AmerWegzyy/IOT_ParkMe/assets/README.md

# Assets

Project media that isn't source code.

## Poster (required for final submission)

The final project poster is stored in `Documentation/images/PARKME_POSTER_2K26-1.png`
and embedded directly in the root `README.md` under the **Poster** section:

```markdown
![ParkMe Project Poster](Documentation/images/PARKME_POSTER_2K26-1.png)
```

## Other assets (optional)

Sound files, project photos, 3D enclosure files (e.g. a printed box for the
boards), etc. can also go here.
`test_pics/` contains google vision api accuracy testing pictures.

> The wiring/connection diagram lives in
> [`../Documentation/images/`](../Documentation/images/) alongside the hardware
> documentation.
