AmerWegzyy/IOT_ParkMe/docs/project_checkpoint.md

# ParkMe Project - Status Checkpoint & Summary

**Date:** June 17, 2026

## 📌 Summary of Recent Work (Yesterday)

* **Architecture & Race Condition Fixes:** 
  * Resolved a race condition where delayed OCR camera success created duplicate logs instead of overwriting the initial `UNIDENTIFIED` ghost log triggered by the ultrasonic sensor.
  * Added "Self-Healing" documentation (`Documentation/hardware_behavior_and_edge_cases.md`) mapping out the exact logging lifecycle and database mutations.
* **Streamlining Local Development:** 
  * Updated `common-commands.md` to reflect our unified server approach. The frontend is now served directly by FastAPI via `StaticFiles`, meaning a single `uvicorn main:app --reload` command serves both the backend API and the frontend web app on port `8000`.
  * Explained environment concepts (`venv`, `environment variables`, `.env`) to help the team understand how Python project dependencies and secrets are managed.
* **Bug Fixes:** 
  * Fixed a local startup crash (`google.auth.exceptions.DefaultCredentialsError`) by integrating `python-dotenv` into `main.py`, `seed_firestore.py`, and `create_auth_users.py`. The backend now automatically loads the `GOOGLE_APPLICATION_CREDENTIALS` from the `.env` file upon startup.
* **Git Cleanliness:** 
  * Updated `.gitignore` to explicitly exclude virtual environments (like `venv2/`) and local agent configurations (`mcp.json`).
  * Provided a step-by-step checklist for the team to clone, configure, and run the project locally.

---

## 📍 Current Project State

* **Backend (FastAPI):** Functioning properly with Firebase/Firestore integration. Handles sensor data, OCR inputs, and serves the static frontend files directly.
* **Frontend:** Functional HTML/CSS/JS frontend that interacts with the backend. 
* **Hardware Integration (ESP32):** Hardware edge-cases and race conditions (e.g., sensor vs. camera timing delays) have been mapped out and handled safely in the backend logic.
* **Database (Firestore):** Seeding scripts are ready and functional. The database schema and logging behaviors are fully established.

---

## 📝 To-Do List / Next Steps

- [ ] **Comprehensive Testing:**
  - [ ] Write and run unit tests for the core backend endpoints.
  - [ ] Perform integration testing between the ESP32 hardware and the backend (simulating real-time parking events).
  - [ ] Test frontend interactions (login, viewing spots, real-time updates).

- [ ] **Deployment:**
  - [ ] **Backend Cloud Deployment:** Deploy the FastAPI backend to a cloud provider (e.g., Google Cloud Run, Render, or Heroku).
  - [ ] **Frontend Firebase Hosting:** Decouple the frontend from the FastAPI server and deploy the static files to Firebase Hosting for faster, dedicated CDN delivery.
  - [ ] Update CORS policies to allow the new Firebase Hosting frontend URL to communicate with the cloud-deployed backend API.
