AmerWegzyy/IOT_ParkMe/assets/test_pics/1234590.jpg

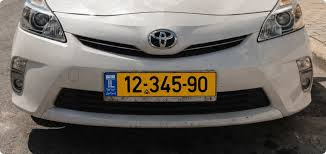
assets/test_pics/1234590.jpg
