AmerWegzyy/IOT_ParkMe/assets/test_pics/1747154.jpg

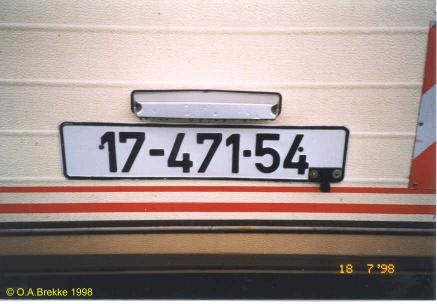
assets/test_pics/1747154.jpg
