AmerWegzyy/IOT_ParkMe/assets/test_pics/1762438.jpg

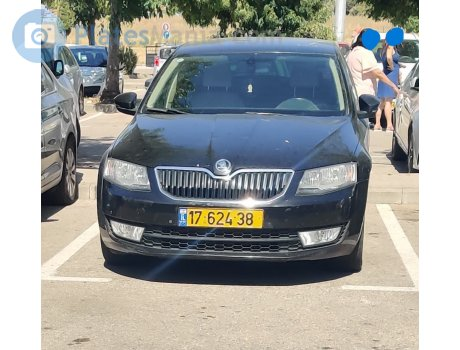
assets/test_pics/1762438.jpg
