AmerWegzyy/IOT_ParkMe/assets/test_pics/1777765.jpg

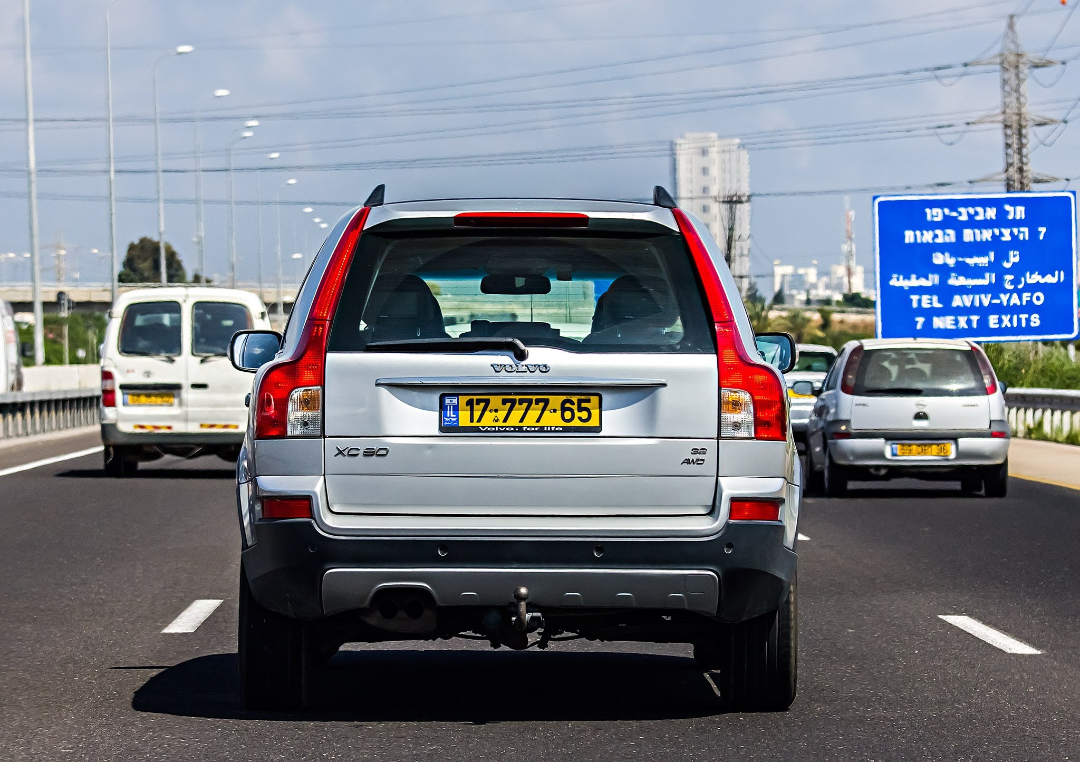
assets/test_pics/1777765.jpg
