AmerWegzyy/IOT_ParkMe/assets/test_pics/3386623.jpg

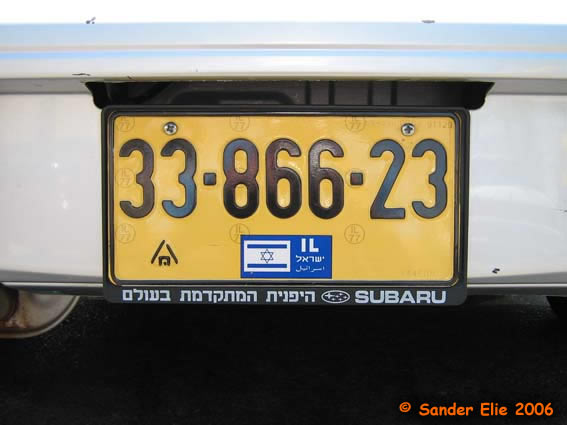
assets/test_pics/3386623.jpg
