AmerWegzyy/IOT_ParkMe/assets/test_pics/4528139.jpg

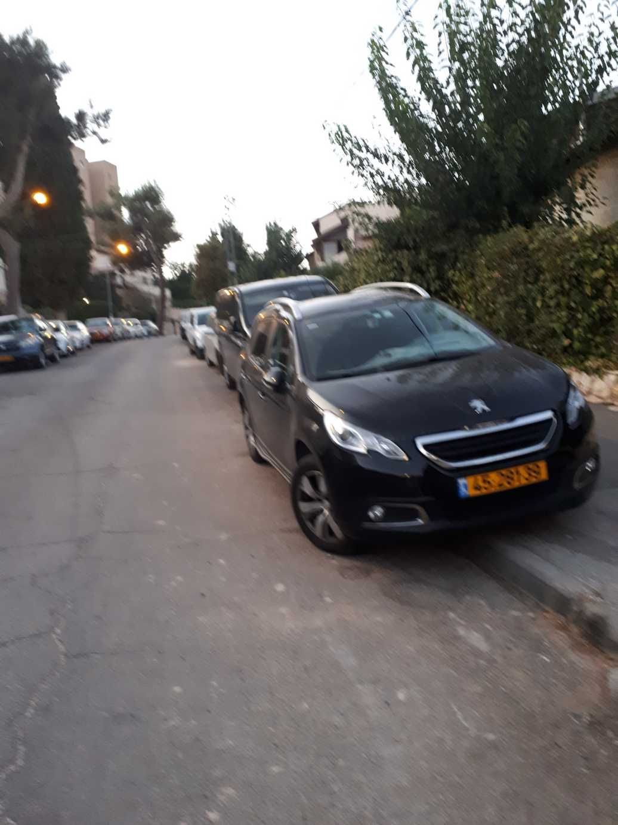
assets/test_pics/4528139.jpg
