AmerWegzyy/IOT_ParkMe/assets/test_pics/5340626.jpg

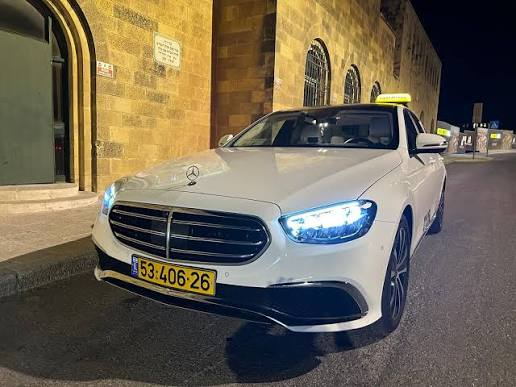
assets/test_pics/5340626.jpg
