AmerWegzyy/IOT_ParkMe/assets/test_pics/5351220.jpg

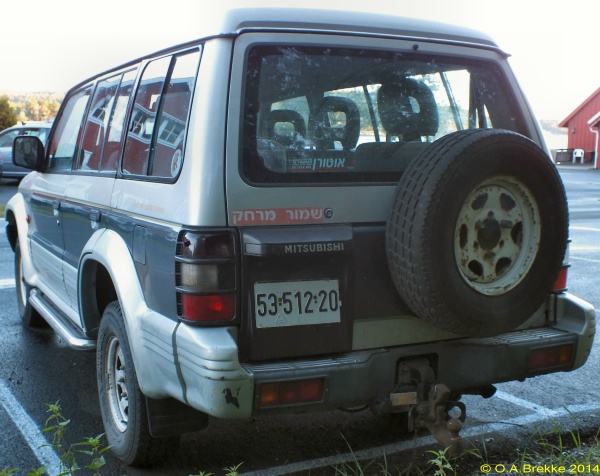
assets/test_pics/5351220.jpg
