AmerWegzyy/IOT_ParkMe/assets/test_pics/5727578.jpg

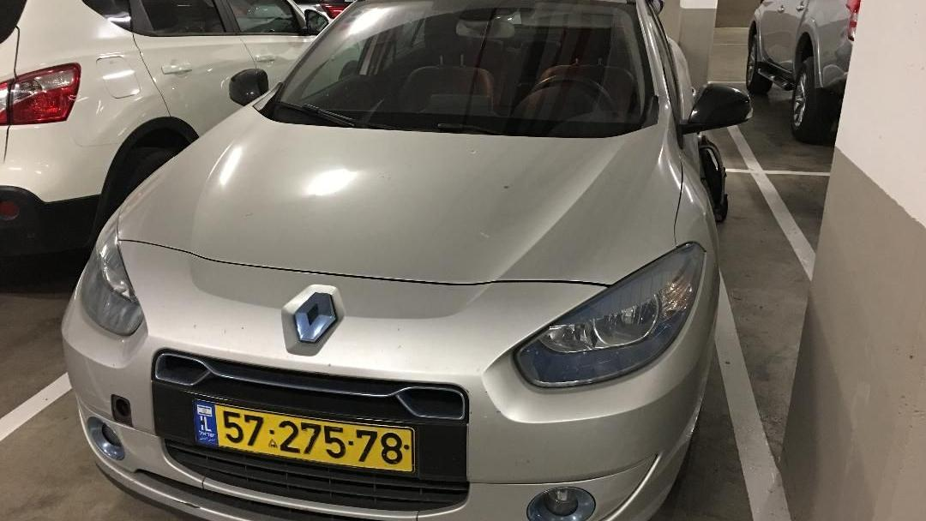
assets/test_pics/5727578.jpg
