AmerWegzyy/IOT_ParkMe/assets/test_pics/5733769.jpg

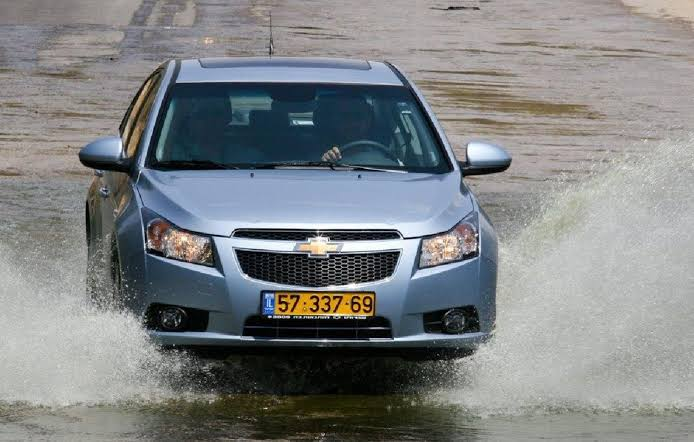
assets/test_pics/5733769.jpg
