AmerWegzyy/IOT_ParkMe/assets/test_pics/5757878.jpg

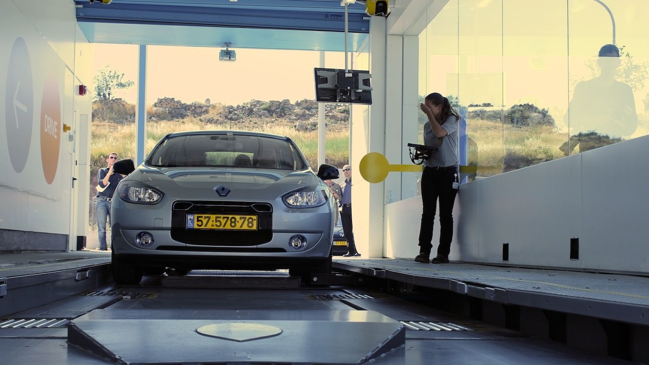
assets/test_pics/5757878.jpg
