AmerWegzyy/IOT_ParkMe/assets/test_pics/6616750.jpg

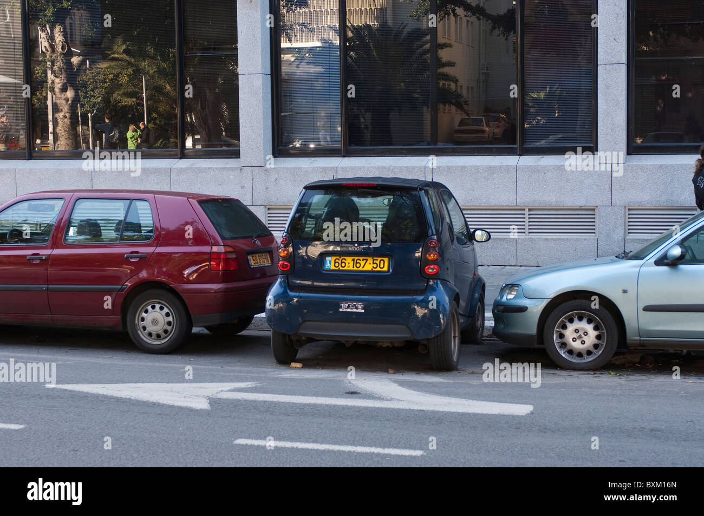
assets/test_pics/6616750.jpg
