AmerWegzyy/IOT_ParkMe/assets/test_pics/7598816.jpg

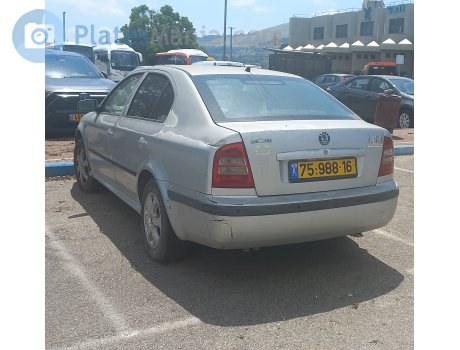
assets/test_pics/7598816.jpg
