AmerWegzyy/IOT_ParkMe/assets/test_pics/7853526.jpg

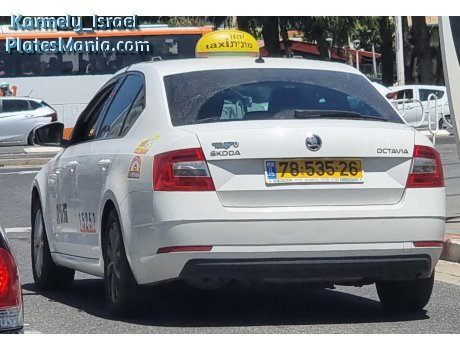
assets/test_pics/7853526.jpg
