AmerWegzyy/IOT_ParkMe/assets/test_pics/7954626.jpg

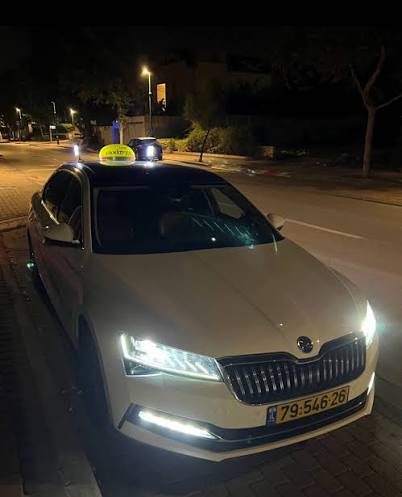
assets/test_pics/7954626.jpg
