AmerWegzyy/IOT_ParkMe/assets/test_pics/9044970.jpg

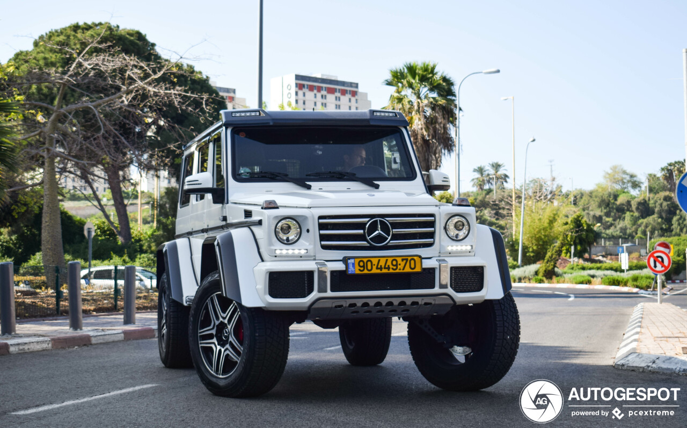
assets/test_pics/9044970.jpg
