AmerWegzyy/IOT_ParkMe/assets/test_pics/9195973.jpg

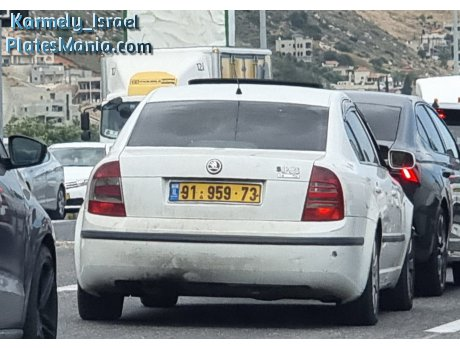
assets/test_pics/9195973.jpg
