AmerWegzyy/IOT_ParkMe/assets/test_pics/9479056.jpg

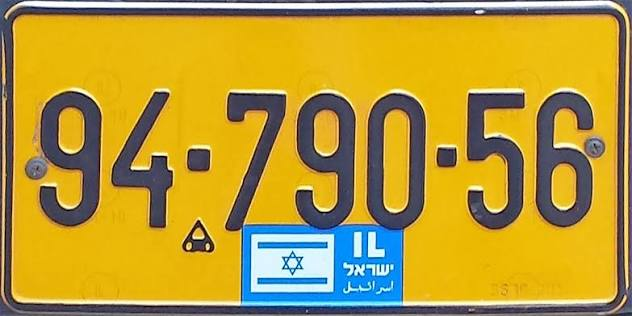
assets/test_pics/9479056.jpg
