AmerWegzyy/IOT_ParkMe/assets/test_pics/9663369.jpg

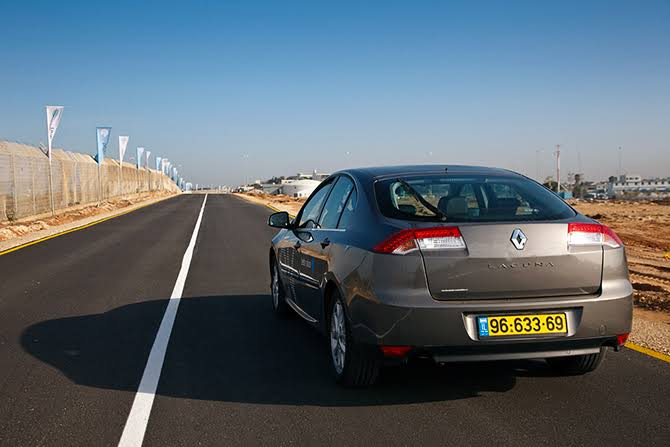
assets/test_pics/9663369.jpg
