AmerWegzyy/IOT_ParkMe/assets/test_pics/9668669.webp

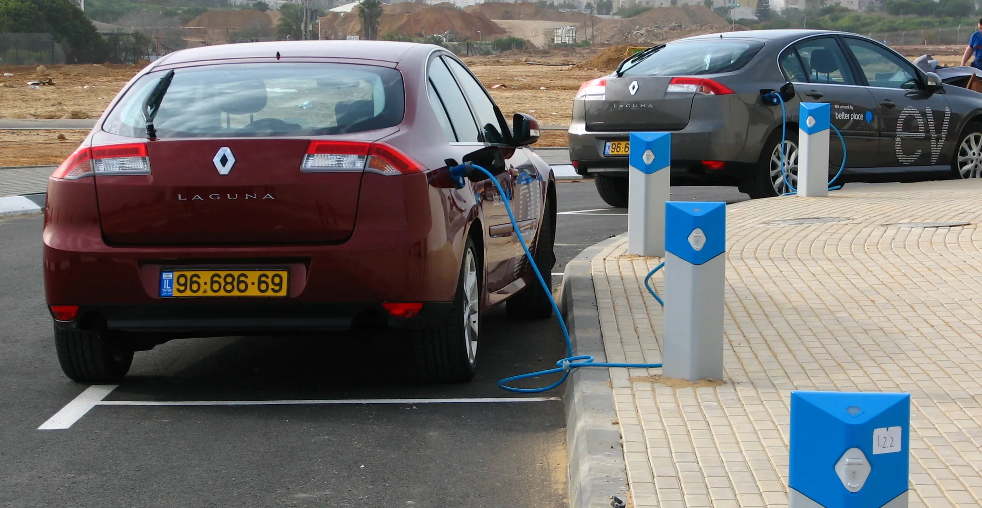
assets/test_pics/9668669.webp
