AmerWegzyy/IOT_ParkMe/assets/test_pics/9703069.jpg

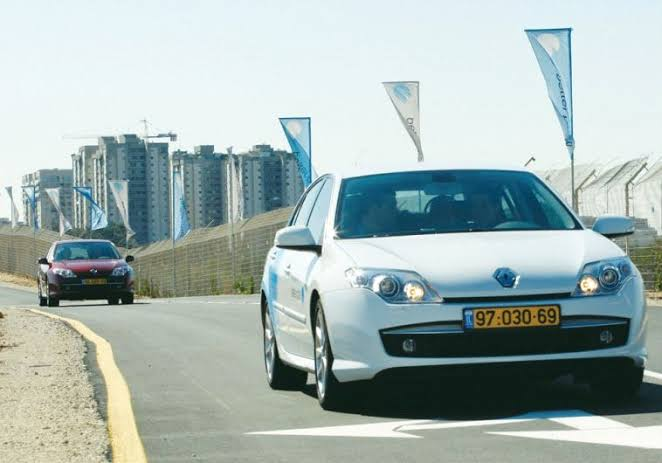
assets/test_pics/9703069.jpg
