AmerWegzyy/IOT_ParkMe/assets/test_pics/9722269.jpg

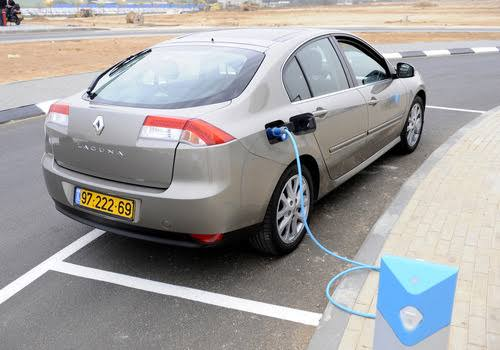
assets/test_pics/9722269.jpg
