AmerWegzyy/IOT_ParkMe/assets/test_pics/26205301.jpg

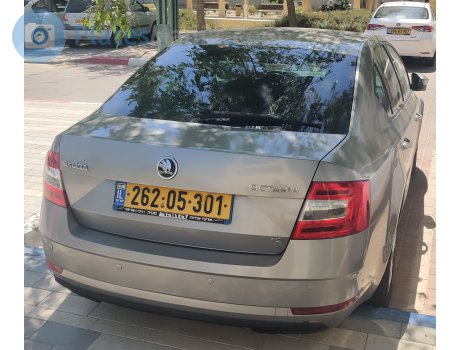
assets/test_pics/26205301.jpg
