AmerWegzyy/IOT_ParkMe/assets/test_pics/28296303.webp

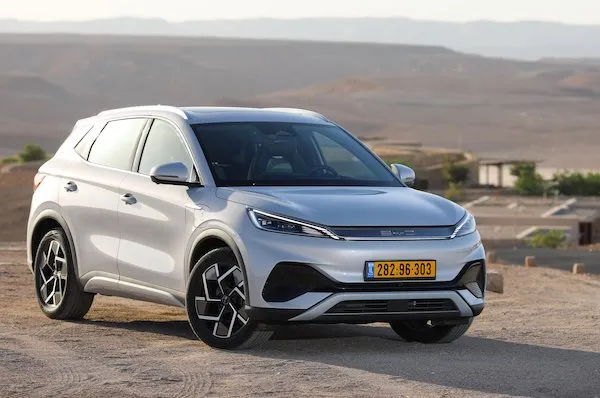
assets/test_pics/28296303.webp
