AmerWegzyy/IOT_ParkMe/assets/test_pics/40940203.jpg

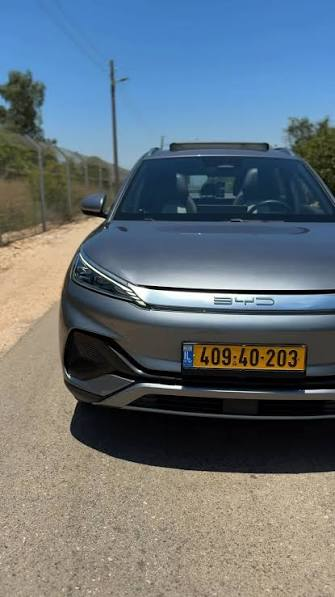
assets/test_pics/40940203.jpg
