AmerWegzyy/IOT_ParkMe/assets/test_pics/47909301.jpg

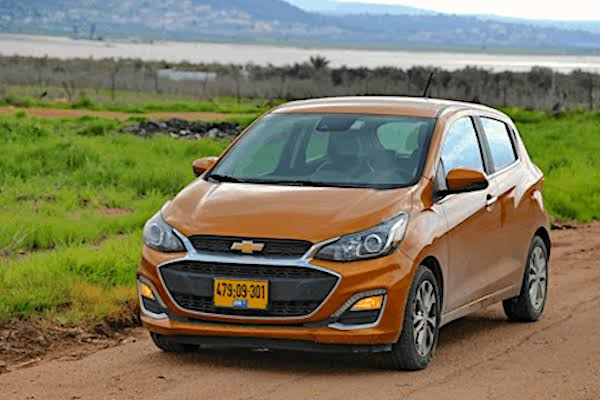
assets/test_pics/47909301.jpg
