AmerWegzyy/IOT_ParkMe/assets/test_pics/49347601.jpg

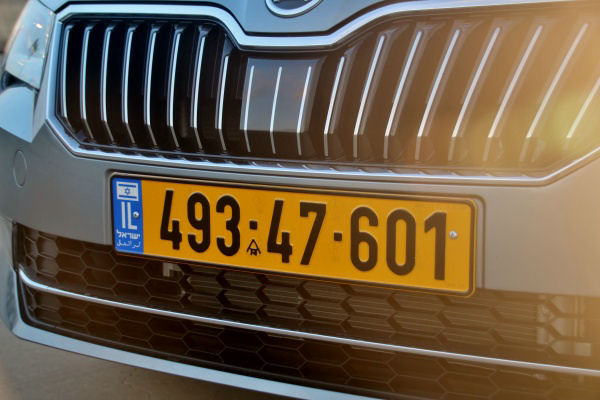
assets/test_pics/49347601.jpg
