AmerWegzyy/IOT_ParkMe/assets/test_pics/57685101.jpg

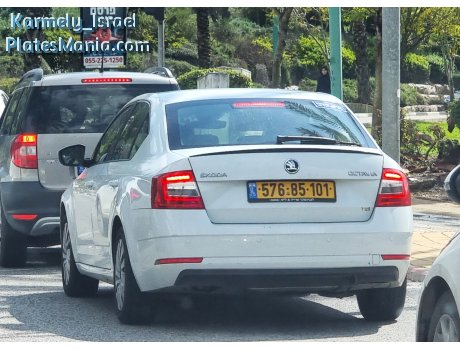
assets/test_pics/57685101.jpg
