AmerWegzyy/IOT_ParkMe/assets/test_pics/60830001.jpg

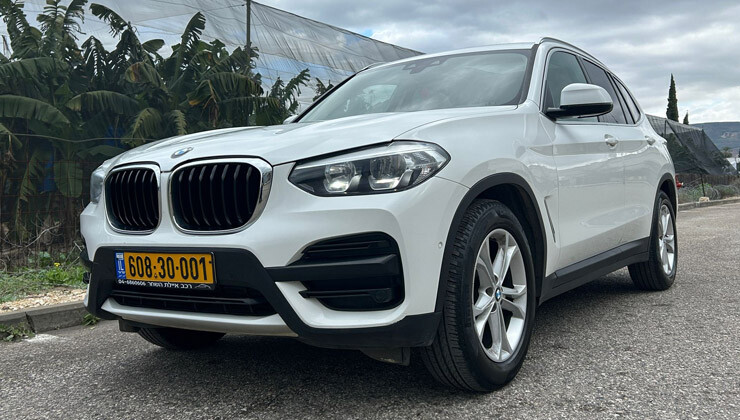
assets/test_pics/60830001.jpg
