AmerWegzyy/IOT_ParkMe/assets/test_pics/71816803.jpg

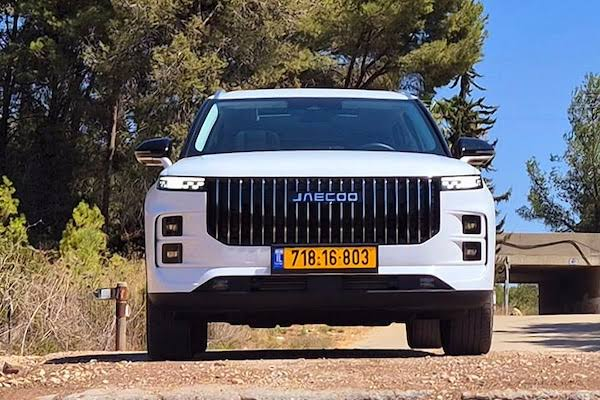
assets/test_pics/71816803.jpg
