AmerWegzyy/IOT_ParkMe/assets/test_pics/77864803.jpg

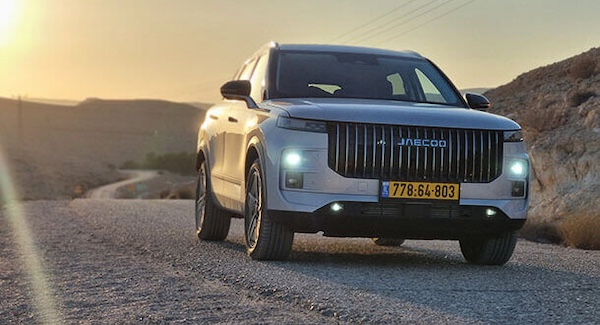
assets/test_pics/77864803.jpg
