AmerWegzyy/IOT_ParkMe/assets/test_pics/83390303.webp

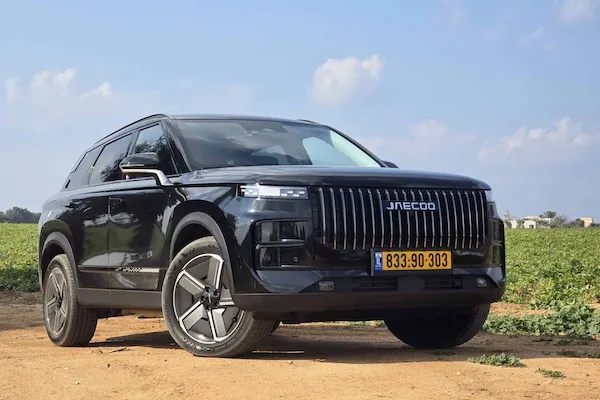
assets/test_pics/83390303.webp
