AmerWegzyy/IOT_ParkMe/ESP32/ParkMeSensorNode/ParkMeSensorNode.ino

#include <HTTPClient.h>
#include <Preferences.h>
#include <esp_now.h>
#include <esp_wifi.h>
#include <WiFi.h>
#include <WiFiClientSecure.h>
#include <Wire.h>

#include "ParkMeCommon.h"
#include "ParkMeConfig.h"

using namespace parkme;

namespace {

Preferences preferences;

struct PendingTelemetry {
  uint8_t status;
  uint8_t batteryPercent;
  uint8_t valid;
  // Set when an unsent FREE (a car leaving) was dropped from this single-slot
  // queue because a later OCCUPIED (the next car) overwrote it during an
  // outage. On reconnect we must deliver a FREE first so the backend closes
  // the previous car's session; otherwise the next car's photo is attributed
  // to the old session and discarded as "already processed".
  uint8_t sessionEndUndelivered;
};

PendingTelemetry pendingTelemetry = {0, 100, 0, 0};

float baselineDistanceCm = PARKME_SENSOR_DEFAULT_BASELINE_CM;
float occupiedThresholdCm = PARKME_SENSOR_OCCUPIED_THRESHOLD_CM;

SpotState lastPublishedState = STATE_UNKNOWN;
unsigned long lastSampleAtMs = 0;
unsigned long lastSuccessfulPublishAtMs = 0;
unsigned long lastWifiAttemptAtMs = 0;
unsigned long calibrationButtonPressedAtMs = 0;
unsigned long lastDisplayPollAtMs = 0;
unsigned long activeMessageUntilAtMs = 0;
unsigned long localCameraMessageUntilAtMs = 0;
unsigned long lastEspNowStateSentAtMs = 0;
// AP channel remembered from the last successful connect; the radio is
// re-pinned to it after failed reconnects so ESP-NOW keeps working during
// WiFi outages (both boards must share a channel for ESP-NOW delivery).
uint8_t lastKnownWifiChannel = 0;

float lastMeasuredDistanceCm = -1.0f;
SpotState lastMeasuredState = STATE_UNKNOWN;
int lastMeasuredBatteryPercent = 100;
SpotState lastEspNowState = STATE_UNKNOWN;
uint32_t lastEspNowSequence = 0;

String currentScreenTitle = "ParkMe";
String currentScreenMessage = "Booting";
String lastRenderedSignature;
String lastEspNowAckDetail;
String localCameraScreenTitle;
String localCameraScreenMessage;

bool graphicsReady = false;
bool espNowReady = false;
uint8_t selectedDisplayAddress = 0;
portMUX_TYPE espNowAckMux = portMUX_INITIALIZER_UNLOCKED;
volatile bool hasPendingEspNowAck = false;
volatile uint8_t pendingEspNowAckStatus = 0;
char pendingEspNowAckDetail[24] = {0};
const uint8_t kEspNowBroadcastPeer[6] = {0xFF, 0xFF, 0xFF, 0xFF, 0xFF, 0xFF};

// FreeRTOS inter-core shared state
SemaphoreHandle_t sharedStateMutex = nullptr;

struct SharedSensorData {
  SpotState state;
  int batteryPercent;
  bool needsTelemetry;
};

struct SharedDisplayCommand {
  char title[24];
  char message[48];
  unsigned long holdMs;
  bool hasNew;
  bool needsAck;
  char requestId[40];
};

struct SharedNetworkStatus {
  bool wifiConnected;
  bool sseConnected;
  unsigned long lastTelemetrySentAtMs;
};

volatile SharedSensorData sharedSensor = {STATE_UNKNOWN, 100, false};
volatile SharedDisplayCommand sharedDisplay = {{0}, {0}, 0, false, false, {0}};
volatile SharedNetworkStatus sharedNetwork = {false, false, 0};

// SSE connection state
unsigned long sseReconnectDelayMs = 3000;
constexpr unsigned long SSE_RECONNECT_MAX_DELAY_MS = 30000;
constexpr unsigned long SSE_RECONNECT_BASE_DELAY_MS = 3000;
unsigned long lastSseAttemptAtMs = 0;
bool sseStreamActive = false;
TaskHandle_t networkTaskHandle = nullptr;
constexpr uint32_t NETWORK_TASK_STACK_SIZE = 8192;

bool addEspNowPeerIfNeeded(const uint8_t peerMac[6]) {
  if (esp_now_is_peer_exist(peerMac)) {
    return true;
  }

  esp_now_peer_info_t peerInfo = {};
  memcpy(peerInfo.peer_addr, peerMac, sizeof(peerInfo.peer_addr));
  peerInfo.channel = 0;
  peerInfo.encrypt = false;
  return esp_now_add_peer(&peerInfo) == ESP_OK;
}

constexpr uint8_t kDisplayWidth = 128;
constexpr uint8_t kDisplayHeight = 64;
constexpr uint8_t kDisplayPages = kDisplayHeight / 8;
constexpr unsigned long kSensorEchoTimeoutUs = 30000;
constexpr float kSensorMeasurementCapCm =
    (kSensorEchoTimeoutUs * 0.0343f) / 2.0f;
uint8_t displayBuffer[kDisplayWidth * kDisplayPages] = {0};

const uint8_t FONT_SPACE[5] = {0x00, 0x00, 0x00, 0x00, 0x00};
// Digit glyphs use the same bit convention as the letters below: bit 0 = top
// row (drawChar tests glyph[col] & (1 << row) with row 0 at the top).
const uint8_t FONT_0[5] = {0x3E, 0x51, 0x49, 0x45, 0x3E};
const uint8_t FONT_1[5] = {0x00, 0x42, 0x7F, 0x40, 0x00};
const uint8_t FONT_2[5] = {0x42, 0x61, 0x51, 0x49, 0x46};
const uint8_t FONT_3[5] = {0x21, 0x41, 0x45, 0x4B, 0x31};
const uint8_t FONT_4[5] = {0x18, 0x14, 0x12, 0x7F, 0x10};
const uint8_t FONT_5[5] = {0x27, 0x45, 0x45, 0x45, 0x39};
const uint8_t FONT_6[5] = {0x3C, 0x4A, 0x49, 0x49, 0x30};
const uint8_t FONT_7[5] = {0x01, 0x71, 0x09, 0x05, 0x03};
const uint8_t FONT_8[5] = {0x36, 0x49, 0x49, 0x49, 0x36};
const uint8_t FONT_9[5] = {0x06, 0x49, 0x49, 0x29, 0x1E};
const uint8_t FONT_A[5] = {0x7E, 0x11, 0x11, 0x11, 0x7E};
const uint8_t FONT_B[5] = {0x7F, 0x49, 0x49, 0x49, 0x36};
const uint8_t FONT_C[5] = {0x3E, 0x41, 0x41, 0x41, 0x22};
const uint8_t FONT_D[5] = {0x7F, 0x41, 0x41, 0x22, 0x1C};
const uint8_t FONT_E[5] = {0x7F, 0x49, 0x49, 0x49, 0x41};
const uint8_t FONT_F[5] = {0x7F, 0x09, 0x09, 0x09, 0x01};
const uint8_t FONT_G[5] = {0x3E, 0x41, 0x49, 0x49, 0x7A};
const uint8_t FONT_H[5] = {0x7F, 0x08, 0x08, 0x08, 0x7F};
const uint8_t FONT_I[5] = {0x00, 0x41, 0x7F, 0x41, 0x00};
const uint8_t FONT_J[5] = {0x20, 0x40, 0x41, 0x3F, 0x01};
const uint8_t FONT_K[5] = {0x7F, 0x08, 0x14, 0x22, 0x41};
const uint8_t FONT_L[5] = {0x7F, 0x40, 0x40, 0x40, 0x40};
const uint8_t FONT_M[5] = {0x7F, 0x02, 0x0C, 0x02, 0x7F};
const uint8_t FONT_N[5] = {0x7F, 0x04, 0x08, 0x10, 0x7F};
const uint8_t FONT_O[5] = {0x3E, 0x41, 0x41, 0x41, 0x3E};
const uint8_t FONT_P[5] = {0x7F, 0x09, 0x09, 0x09, 0x06};
const uint8_t FONT_Q[5] = {0x3E, 0x41, 0x51, 0x21, 0x5E};
const uint8_t FONT_R[5] = {0x7F, 0x09, 0x19, 0x29, 0x46};
const uint8_t FONT_S[5] = {0x46, 0x49, 0x49, 0x49, 0x31};
const uint8_t FONT_T[5] = {0x01, 0x01, 0x7F, 0x01, 0x01};
const uint8_t FONT_U[5] = {0x3F, 0x40, 0x40, 0x40, 0x3F};
const uint8_t FONT_V[5] = {0x1F, 0x20, 0x40, 0x20, 0x1F};
const uint8_t FONT_W[5] = {0x7F, 0x20, 0x18, 0x20, 0x7F};
const uint8_t FONT_X[5] = {0x63, 0x14, 0x08, 0x14, 0x63};
const uint8_t FONT_Y[5] = {0x03, 0x04, 0x78, 0x04, 0x03};
const uint8_t FONT_Z[5] = {0x61, 0x51, 0x49, 0x45, 0x43};

}  // namespace

void handleEspNowSend(const uint8_t *macAddress, esp_now_send_status_t status) {
  Serial.print("ESP-NOW send to ");
  Serial.print(formatMacAddress(macAddress));
  Serial.print(": ");
  Serial.println(status == ESP_NOW_SEND_SUCCESS ? "ok" : "failed");
}

void handleEspNowReceive(const uint8_t *macAddress,
                         const uint8_t *data,
                         int dataLength) {
  if (dataLength != static_cast<int>(sizeof(EspNowCameraAckMessage))) {
    return;
  }

  EspNowCameraAckMessage message = {};
  memcpy(&message, data, sizeof(message));
  if (!isEspNowMessageEnvelopeValid(message, ESPNOW_MESSAGE_CAMERA_ACK)) {
    return;
  }

  lastEspNowAckDetail = String(message.detail);
  Serial.print("ESP-NOW ack from ");
  Serial.print(formatMacAddress(macAddress));
  Serial.print(" seq=");
  Serial.print(message.sequence);
  Serial.print(" status=");
  Serial.print(message.status);
  if (lastEspNowAckDetail.length() > 0) {
    Serial.print(" detail=");
    Serial.print(lastEspNowAckDetail);
  }
  Serial.println();

  portENTER_CRITICAL(&espNowAckMux);
  pendingEspNowAckStatus = message.status;
  memcpy(pendingEspNowAckDetail, message.detail, sizeof(pendingEspNowAckDetail));
  hasPendingEspNowAck = true;
  portEXIT_CRITICAL(&espNowAckMux);
}

bool initEspNow() {
  uint8_t peerMac[6];
  bool hasConfiguredCameraPeer =
      parseMacAddress(PARKME_CAMERA_ESPNOW_PEER_MAC, peerMac);

  if (esp_now_init() != ESP_OK) {
    Serial.println("ESP-NOW init failed on sensor node.");
    return false;
  }

  esp_now_register_send_cb(handleEspNowSend);
  esp_now_register_recv_cb(handleEspNowReceive);

  if (!addEspNowPeerIfNeeded(kEspNowBroadcastPeer)) {
    Serial.println("ESP-NOW could not add the broadcast peer.");
    return false;
  }

  if (hasConfiguredCameraPeer && !addEspNowPeerIfNeeded(peerMac)) {
    Serial.println("ESP-NOW could not add the configured camera peer.");
    return false;
  }

  if (hasConfiguredCameraPeer) {
    Serial.print("ESP-NOW ready. Camera peer: ");
    Serial.println(PARKME_CAMERA_ESPNOW_PEER_MAC);
    Serial.println("ESP-NOW broadcast fallback is also enabled.");
  } else {
    Serial.println("ESP-NOW ready. Using broadcast trigger because the camera peer MAC is empty or invalid.");
  }
  return true;
}

bool takePendingEspNowAck(uint8_t &status, char detailBuffer[24]) {
  bool hasAck = false;
  portENTER_CRITICAL(&espNowAckMux);
  if (hasPendingEspNowAck) {
    status = pendingEspNowAckStatus;
    memcpy(detailBuffer, pendingEspNowAckDetail, 24);
    hasPendingEspNowAck = false;
    hasAck = true;
  }
  portEXIT_CRITICAL(&espNowAckMux);
  return hasAck;
}

bool isTimedMessageActive(unsigned long expiresAtMs) {
  return expiresAtMs > 0 && static_cast<long>(millis() - expiresAtMs) < 0;
}

bool isServerMessageActive() {
  return isTimedMessageActive(activeMessageUntilAtMs);
}

bool isLocalCameraMessageActive() {
  return isTimedMessageActive(localCameraMessageUntilAtMs);
}

bool shouldSendEspNowState(SpotState state, unsigned long nowMs) {
  if (!espNowReady || !isKnownState(state)) {
    return false;
  }

  if (!isKnownState(lastEspNowState) || state != lastEspNowState) {
    return true;
  }

  return nowMs - lastEspNowStateSentAtMs >=
         PARKME_SENSOR_ESPNOW_STATE_SYNC_INTERVAL_MS;
}

void sendEspNowState(SpotState state, int batteryPercent) {
  if (!espNowReady) {
    return;
  }

  unsigned long nowMs = millis();
  if (!shouldSendEspNowState(state, nowMs)) {
    return;
  }

  if (!isKnownState(lastEspNowState) || state != lastEspNowState) {
    lastEspNowSequence++;
    lastEspNowState = state;
  }

  EspNowSensorStateMessage message = {};
  message.magic = PARKME_ESPNOW_PROTOCOL_MAGIC;
  message.version = PARKME_ESPNOW_PROTOCOL_VERSION;
  message.messageType = ESPNOW_MESSAGE_SENSOR_STATE;
  message.sequence = lastEspNowSequence;
  message.state = static_cast<uint8_t>(state);
  message.batteryPercent =
      static_cast<uint8_t>(clampValue(batteryPercent, 0, 100));
  copyStringToFixedBuffer(String(PARKME_GATE_SPOT_ID),
                          message.spotId,
                          sizeof(message.spotId));
  copyStringToFixedBuffer(WiFi.macAddress(),
                          message.senderMac,
                          sizeof(message.senderMac));

  bool sentSuccessfully = false;
  bool directQueued = false;
  bool broadcastQueued = false;

  uint8_t peerMac[6];
  if (parseMacAddress(PARKME_CAMERA_ESPNOW_PEER_MAC, peerMac)) {
    esp_err_t directStatus =
        esp_now_send(peerMac, reinterpret_cast<const uint8_t *>(&message),
                     sizeof(message));
    if (directStatus == ESP_OK) {
      sentSuccessfully = true;
      directQueued = true;
    } else {
      Serial.print("ESP-NOW direct send failed with status ");
      Serial.println(static_cast<int>(directStatus));
    }
  }

  esp_err_t broadcastStatus =
      esp_now_send(kEspNowBroadcastPeer,
                   reinterpret_cast<const uint8_t *>(&message),
                   sizeof(message));
  if (broadcastStatus == ESP_OK) {
    sentSuccessfully = true;
    broadcastQueued = true;
  } else {
    Serial.print("ESP-NOW broadcast send failed with status ");
    Serial.println(static_cast<int>(broadcastStatus));
  }

  if (sentSuccessfully) {
    lastEspNowStateSentAtMs = nowMs;
    Serial.print("ESP-NOW state queued seq=");
    Serial.print(message.sequence);
    Serial.print(" state=");
    Serial.print(state == STATE_OCCUPIED ? "OCCUPIED" : "FREE");
    Serial.print(" direct=");
    Serial.print(directQueued ? "yes" : "no");
    Serial.print(" broadcast=");
    Serial.println(broadcastQueued ? "yes" : "no");
  }
}

const uint8_t *fontFor(char c) {
  switch (c) {
    case '0': return FONT_0;
    case '1': return FONT_1;
    case '2': return FONT_2;
    case '3': return FONT_3;
    case '4': return FONT_4;
    case '5': return FONT_5;
    case '6': return FONT_6;
    case '7': return FONT_7;
    case '8': return FONT_8;
    case '9': return FONT_9;
    case 'A': return FONT_A;
    case 'B': return FONT_B;
    case 'C': return FONT_C;
    case 'D': return FONT_D;
    case 'E': return FONT_E;
    case 'F': return FONT_F;
    case 'G': return FONT_G;
    case 'H': return FONT_H;
    case 'I': return FONT_I;
    case 'J': return FONT_J;
    case 'K': return FONT_K;
    case 'L': return FONT_L;
    case 'M': return FONT_M;
    case 'N': return FONT_N;
    case 'O': return FONT_O;
    case 'P': return FONT_P;
    case 'Q': return FONT_Q;
    case 'R': return FONT_R;
    case 'S': return FONT_S;
    case 'T': return FONT_T;
    case 'U': return FONT_U;
    case 'V': return FONT_V;
    case 'W': return FONT_W;
    case 'X': return FONT_X;
    case 'Y': return FONT_Y;
    case 'Z': return FONT_Z;
    default: return FONT_SPACE;
  }
}

String normalizeDisplayText(String text) {
  text.replace("\n", " ");
  text.toUpperCase();

  for (size_t i = 0; i < text.length(); ++i) {
    char c = text[i];
    bool allowed = (c >= 'A' && c <= 'Z') ||
                   (c >= '0' && c <= '9') ||
                   c == ' ';
    if (!allowed) {
      text.setCharAt(i, ' ');
    }
  }

  return text;
}

void oledCommand(uint8_t command) {
  Wire.beginTransmission(selectedDisplayAddress);
  Wire.write(0x00);
  Wire.write(command);
  Wire.endTransmission();
}

void oledData(const uint8_t *data, uint8_t length) {
  Wire.beginTransmission(selectedDisplayAddress);
  Wire.write(0x40);
  for (uint8_t i = 0; i < length; ++i) {
    Wire.write(data[i]);
  }
  Wire.endTransmission();
}

bool oledAddressResponds(uint8_t address) {
  Wire.beginTransmission(address);
  return Wire.endTransmission() == 0;
}

void oledInit() {
  oledCommand(0xAE);
  oledCommand(0xD5);
  oledCommand(0x80);
  oledCommand(0xA8);
  oledCommand(0x3F);
  oledCommand(0xD3);
  oledCommand(0x00);
  oledCommand(0x40);
  oledCommand(0x8D);
  oledCommand(0x14);
  oledCommand(0xA1);
  oledCommand(0xC8);
  oledCommand(0xDA);
  oledCommand(0x12);
  oledCommand(0x81);
  oledCommand(0xFF);
  oledCommand(0xD9);
  oledCommand(0xF1);
  oledCommand(0xDB);
  oledCommand(0x40);
  oledCommand(0xA4);
  oledCommand(0xA6);
  oledCommand(0xAF);
}

void oledDisplay() {
  for (uint8_t page = 0; page < kDisplayPages; ++page) {
    uint8_t column = PARKME_DISPLAY_COLUMN_OFFSET;
    oledCommand(0xB0 + page);
    oledCommand(0x00 + (column & 0x0F));
    oledCommand(0x10 + ((column >> 4) & 0x0F));

    const uint8_t *pageData = &displayBuffer[page * kDisplayWidth];
    for (uint8_t x = 0; x < kDisplayWidth; x += 16) {
      oledData(&pageData[x], 16);
    }
  }
}

void clearDisplayBuffer() {
  memset(displayBuffer, 0, sizeof(displayBuffer));
}

void setPixel(uint8_t x, uint8_t y, bool enabled) {
  if (x >= kDisplayWidth || y >= kDisplayHeight) {
    return;
  }

  uint16_t index = x + (y / 8) * kDisplayWidth;
  uint8_t mask = 1 << (y % 8);
  if (enabled) {
    displayBuffer[index] |= mask;
  } else {
    displayBuffer[index] &= ~mask;
  }
}

void drawChar(uint8_t x, uint8_t y, char c, uint8_t scale) {
  const uint8_t *glyph = fontFor(c);
  for (uint8_t col = 0; col < 5; ++col) {
    for (uint8_t row = 0; row < 7; ++row) {
      bool pixelOn = glyph[col] & (1 << row);
      for (uint8_t dx = 0; dx < scale; ++dx) {
        for (uint8_t dy = 0; dy < scale; ++dy) {
          setPixel(x + col * scale + dx, y + row * scale + dy, pixelOn);
        }
      }
    }
  }
}

void drawText(uint8_t x, uint8_t y, const String &text, uint8_t scale) {
  uint8_t cursorX = x;
  for (size_t i = 0; i < text.length(); ++i) {
    drawChar(cursorX, y, text[i], scale);
    cursorX += 6 * scale;
  }
}

void splitMessageIntoLines(const String &message, String &line1, String &line2) {
  constexpr size_t kMaxCharsPerLine = 18;
  String normalized = message;
  normalized.replace("\n", " ");
  normalized.trim();

  if (normalized.length() <= kMaxCharsPerLine) {
    line1 = normalized;
    line2 = "";
    return;
  }

  int splitAt = normalized.lastIndexOf(' ', kMaxCharsPerLine);
  if (splitAt <= 0) {
    splitAt = static_cast<int>(kMaxCharsPerLine);
  }

  line1 = normalized.substring(0, splitAt);
  line1.trim();

  line2 = normalized.substring(splitAt);
  line2.trim();
  if (line2.length() > kMaxCharsPerLine) {
    line2 = line2.substring(0, kMaxCharsPerLine);
    line2.trim();
  }
}

void renderToSerial(const String &title, const String &message) {
  String signature = title + "|" + message;
  if (signature == lastRenderedSignature) {
    return;
  }

  lastRenderedSignature = signature;
  Serial.println();
  Serial.println("=== Screen Update ===");
  Serial.println(title);
  if (message.length() > 0) {
    Serial.println(message);
  }
  Serial.println("=====================");
}

void renderToGraphics(const String &title, const String &message) {
  if (!graphicsReady) {
    return;
  }

  String normalizedTitle = normalizeDisplayText(title);
  String normalizedMessage = normalizeDisplayText(message);
  String line1;
  String line2;
  splitMessageIntoLines(normalizedMessage, line1, line2);
  normalizedTitle = fitForLcd(normalizedTitle, 10);
  line1 = fitForLcd(line1, 16);
  line2 = fitForLcd(line2, 16);

  clearDisplayBuffer();
  drawText(4, 4, normalizedTitle, 2);
  drawText(4, 28, line1, 1);
  drawText(4, 44, line2, 1);
  oledDisplay();
}

void showScreen(const String &title, const String &message) {
  currentScreenTitle = title;
  currentScreenMessage = message;
  renderToSerial(title, message);
  renderToGraphics(title, message);
}

bool beginGraphicsDisplay() {
  if (!PARKME_DISPLAY_ENABLE_GRAPHICS) {
    Serial.println("Graphics display disabled in SECRETS.h. Using serial only.");
    return false;
  }

  Wire.begin(PARKME_DISPLAY_SDA_PIN, PARKME_DISPLAY_SCL_PIN);
  Wire.setClock(100000);

  bool foundConfiguredAddress = false;
  uint8_t firstDetectedAddress = 0;
  Serial.print("Scanning I2C on SDA=");
  Serial.print(PARKME_DISPLAY_SDA_PIN);
  Serial.print(" SCL=");
  Serial.println(PARKME_DISPLAY_SCL_PIN);
  for (uint8_t address = 1; address < 127; ++address) {
    Wire.beginTransmission(address);
    uint8_t error = Wire.endTransmission();
    if (error == 0) {
      Serial.print("I2C device found at 0x");
      if (address < 16) {
        Serial.print('0');
      }
      Serial.println(address, HEX);
      if (firstDetectedAddress == 0) {
        firstDetectedAddress = address;
      }
      if (address == PARKME_DISPLAY_I2C_ADDRESS) {
        foundConfiguredAddress = true;
      }
    }
  }

  Serial.print("Configured display address: 0x");
  if (PARKME_DISPLAY_I2C_ADDRESS < 16) {
    Serial.print('0');
  }
  Serial.println(PARKME_DISPLAY_I2C_ADDRESS, HEX);

  if (!foundConfiguredAddress) {
    Serial.println("Configured display address was not found on the I2C bus.");
  }

  uint8_t selectedAddress = PARKME_DISPLAY_I2C_ADDRESS;
  if (!foundConfiguredAddress && firstDetectedAddress != 0) {
    selectedAddress = firstDetectedAddress;
    Serial.print("Using detected display address instead: 0x");
    if (selectedAddress < 16) {
      Serial.print('0');
    }
    Serial.println(selectedAddress, HEX);
  }

  if (selectedAddress == 0) {
    Serial.println("No I2C display address available.");
    return false;
  }

  if (!oledAddressResponds(selectedAddress)) {
    Serial.println("Selected OLED address did not respond.");
    return false;
  }

  selectedDisplayAddress = selectedAddress;
  Serial.println("Display driver: LOW-LEVEL SSD1306/SH1106 STYLE");
  oledInit();
  clearDisplayBuffer();
  drawText(10, 12, "WELCOME", 2);
  drawText(34, 44, "PARKME", 1);
  oledDisplay();
  delay(500);
  return true;
}

void showLocalSensorScreen() {
  String title = String("Spot ") + PARKME_GATE_SPOT_ID;
  String message;

  if (!isKnownState(lastMeasuredState)) {
    message = "Waiting sensor";
  } else if (lastMeasuredState == STATE_OCCUPIED) {
    message = "Occupied ";
    if (lastMeasuredDistanceCm > 0.0f) {
      message += String(lastMeasuredDistanceCm, 0);
      message += "cm";
    }
  } else {
    message = "Free ";
    if (lastMeasuredDistanceCm > 0.0f) {
      message += String(lastMeasuredDistanceCm, 0);
      message += "cm";
    }
  }

  message += " B";
  message += String(lastMeasuredBatteryPercent);
  message += "%";

  showScreen(title, message);
}

void clearLocalCameraMessage() {
  localCameraMessageUntilAtMs = 0;
  localCameraScreenTitle = "";
  localCameraScreenMessage = "";
}

void showPreferredLocalScreen() {
  if (isServerMessageActive()) {
    return;
  }

  if (isLocalCameraMessageActive()) {
    showScreen(localCameraScreenTitle, localCameraScreenMessage);
    return;
  }

  showLocalSensorScreen();
}

void showLocalCameraMessage(const String &title,
                            const String &message,
                            unsigned long holdMs) {
  localCameraScreenTitle = title;
  localCameraScreenMessage = message;
  localCameraMessageUntilAtMs = millis() + holdMs;
  showPreferredLocalScreen();
}

void handleCameraAckDisplay(uint8_t status, const char *detail) {
  if (detail && *detail) {
    lastEspNowAckDetail = String(detail);
  }

  switch (status) {
    case ESPNOW_CAMERA_ACK_RECEIVED:
      showLocalCameraMessage("Camera ready",
                             "Queued",
                             PARKME_DISPLAY_CAMERA_QUEUED_HOLD_MS);
      break;
    case ESPNOW_CAMERA_ACK_CAPTURE_STARTED:
      showLocalCameraMessage("Taking photo",
                             "Please hold",
                             PARKME_DISPLAY_CAMERA_STARTED_HOLD_MS);
      break;
    case ESPNOW_CAMERA_ACK_CAPTURE_COMPLETED:
      showLocalCameraMessage("Photo sent",
                             "Checking plate",
                             PARKME_DISPLAY_CAMERA_COMPLETED_HOLD_MS);
      break;
    case ESPNOW_CAMERA_ACK_CAPTURE_FAILED:
      showLocalCameraMessage("Photo failed",
                             "Check dashboard",
                             PARKME_DISPLAY_CAMERA_FAILED_HOLD_MS);
      break;
    case ESPNOW_CAMERA_ACK_SPOT_FREED:
      clearLocalCameraMessage();
      showPreferredLocalScreen();
      break;
    default:
      break;
  }
}

unsigned long extractJsonUnsignedLongField(const String &payload,
                                           const char *fieldName,
                                           unsigned long fallbackValue) {
  String keyPattern = "\"";
  keyPattern += fieldName;
  keyPattern += "\"";

  int keyStart = payload.indexOf(keyPattern);
  if (keyStart < 0) {
    return fallbackValue;
  }

  int colonIndex = payload.indexOf(':', keyStart + keyPattern.length());
  if (colonIndex < 0) {
    return fallbackValue;
  }

  int valueStart = colonIndex + 1;
  while (valueStart < payload.length() &&
         isspace(static_cast<unsigned char>(payload[valueStart]))) {
    ++valueStart;
  }

  int valueEnd = valueStart;
  while (valueEnd < payload.length() &&
         isdigit(static_cast<unsigned char>(payload[valueEnd]))) {
    ++valueEnd;
  }

  if (valueEnd <= valueStart) {
    return fallbackValue;
  }

  return static_cast<unsigned long>(
      payload.substring(valueStart, valueEnd).toInt());
}

bool sendDisplayJsonRequest(const char *path,
                            const String &payload,
                            String &responseBody,
                            int &httpStatusCode) {
  WiFiClient plainClient;
  WiFiClientSecure secureClient;
  Client *client =
      String(PARKME_SERVER_SCHEME) == "https" ? &secureClient : &plainClient;
  secureClient.setInsecure();
  client->setTimeout(PARKME_DISPLAY_HTTP_TIMEOUT_MS);

  if (!client->connect(PARKME_SERVER_HOST, PARKME_SERVER_PORT)) {
    Serial.println("Display request cannot reach backend.");
    return false;
  }

  client->print(String("POST ") + path + " HTTP/1.1\r\n");
  client->print(String("Host: ") + PARKME_SERVER_HOST + "\r\n");
  client->print("Connection: close\r\n");
  client->print("Content-Type: application/json\r\n");
  client->print("Content-Length: " + String(payload.length()) + "\r\n\r\n");
  client->print(payload);

  unsigned long waitStartedAtMs = millis();
  while (!client->available() && client->connected() &&
         millis() - waitStartedAtMs < PARKME_DISPLAY_HTTP_TIMEOUT_MS) {
    delay(10);
  }

  if (!client->available()) {
    client->stop();
    Serial.println("Display backend response timeout.");
    return false;
  }

  String statusLine = client->readStringUntil('\n');
  httpStatusCode = parseHttpStatusCode(statusLine);

  while (client->connected()) {
    String headerLine = client->readStringUntil('\n');
    if (headerLine == "\r" || headerLine.length() == 0) {
      break;
    }
  }

  responseBody = client->readString();
  client->stop();
  return true;
}

bool pollDisplayCommand(String &requestId,
                        String &title,
                        String &message,
                        unsigned long &holdMs) {
  String payload = "{\"display_id\":\"";
  payload += PARKME_DISPLAY_ID;
  payload += "\"}";

  String responseBody;
  int httpStatusCode = -1;
  if (!sendDisplayJsonRequest(PARKME_API_DISPLAY_POLL_PATH,
                              payload,
                              responseBody,
                              httpStatusCode)) {
    return false;
  }

  if (httpStatusCode < 200 || httpStatusCode >= 300) {
    Serial.print("Display poll rejected with HTTP ");
    Serial.println(httpStatusCode);
    return false;
  }

  String action = extractJsonStringField(responseBody, "action");
  action.toUpperCase();
  if (action != "SHOW_MESSAGE") {
    return false;
  }

  requestId = extractJsonStringField(responseBody, "request_id");
  title = extractJsonStringField(responseBody, "title");
  message = extractJsonStringField(responseBody, "message");
  holdMs = extractJsonUnsignedLongField(responseBody, "hold_ms", 4000);
  return requestId.length() > 0;
}

void sendDisplayResult(const String &requestId,
                       const String &statusText,
                       const String &detail) {
  String payload = "{\"display_id\":\"";
  payload += PARKME_DISPLAY_ID;
  payload += "\",\"request_id\":\"";
  payload += requestId;
  payload += "\",\"status\":\"";
  payload += statusText;
  payload += "\",\"detail\":\"";
  payload += detail;
  payload += "\"}";

  String responseBody;
  int httpStatusCode = -1;
  if (!sendDisplayJsonRequest(PARKME_API_DISPLAY_RESULT_PATH,
                              payload,
                              responseBody,
                              httpStatusCode)) {
    Serial.println("Failed to acknowledge display command.");
    return;
  }

  Serial.print("Display ACK HTTP ");
  Serial.print(httpStatusCode);
  Serial.print(" | ");
  Serial.println(responseBody);
}

void handleDisplayPolling() {
  bool shouldRefreshScreen = false;

  if (activeMessageUntilAtMs > 0 &&
      static_cast<long>(millis() - activeMessageUntilAtMs) >= 0) {
    activeMessageUntilAtMs = 0;
    shouldRefreshScreen = true;
  }

  if (localCameraMessageUntilAtMs > 0 &&
      static_cast<long>(millis() - localCameraMessageUntilAtMs) >= 0) {
    clearLocalCameraMessage();
    shouldRefreshScreen = true;
  }

  if (shouldRefreshScreen) {
    showPreferredLocalScreen();
  }

  if (WiFi.status() != WL_CONNECTED) {
    return;
  }

  if (millis() - lastDisplayPollAtMs < PARKME_DISPLAY_COMMAND_POLL_INTERVAL_MS) {
    return;
  }

  lastDisplayPollAtMs = millis();

  String requestId;
  String title;
  String message;
  unsigned long holdMs = 4000;
  if (pollDisplayCommand(requestId, title, message, holdMs)) {
    Serial.print("Display command received: ");
    Serial.println(requestId);
    clearLocalCameraMessage();
    activeMessageUntilAtMs = millis() + holdMs;
    showScreen(title.length() > 0 ? title : "ParkMe", message);
    sendDisplayResult(requestId, "DISPLAYED", "rendered");
  }
}

float readDistanceCm() {
  digitalWrite(PARKME_SENSOR_TRIG_PIN, LOW);
  delayMicroseconds(2);

  digitalWrite(PARKME_SENSOR_TRIG_PIN, HIGH);
  delayMicroseconds(10);
  digitalWrite(PARKME_SENSOR_TRIG_PIN, LOW);

  long durationUs = pulseIn(PARKME_SENSOR_ECHO_PIN, HIGH, kSensorEchoTimeoutUs);
  if (durationUs == 0) {
    return -1.0f;
  }

  return (durationUs * 0.0343f) / 2.0f;
}

bool calibrationButtonPressed() {
  if (PARKME_SENSOR_CALIBRATE_PIN < 0) {
    return false;
  }
  return digitalRead(PARKME_SENSOR_CALIBRATE_PIN) == LOW;
}

void persistPendingTelemetry() {
  preferences.putBytes("pending", &pendingTelemetry, sizeof(pendingTelemetry));
}

void clearPendingTelemetry() {
  pendingTelemetry.valid = 0;
  // Note: sessionEndUndelivered is intentionally NOT cleared here — a delivered
  // OCCUPIED does not undo the fact that a car-left event still owes the backend
  // a FREE. It is cleared only once that FREE is actually sent.
  persistPendingTelemetry();
}

void queuePendingTelemetry(SpotState state, int batteryPercent) {
  // If we're about to overwrite an unsent FREE with an OCCUPIED, the car-left
  // event would be lost. Remember it so the reconnect flush sends a FREE first.
  if (pendingTelemetry.valid &&
      static_cast<SpotState>(pendingTelemetry.status) == STATE_FREE &&
      state == STATE_OCCUPIED) {
    pendingTelemetry.sessionEndUndelivered = 1;
  }
  pendingTelemetry.status = static_cast<uint8_t>(state);
  pendingTelemetry.batteryPercent =
      static_cast<uint8_t>(clampValue(batteryPercent, 0, 100));
  pendingTelemetry.valid = 1;
  persistPendingTelemetry();
}

void loadPendingTelemetry() {
  size_t loaded =
      preferences.getBytes("pending", &pendingTelemetry, sizeof(pendingTelemetry));
  if (loaded != sizeof(pendingTelemetry)) {
    pendingTelemetry = {0, 100, 0, 0};
  }
}

// If a car-left (FREE) was dropped from the queue by a later OCCUPIED, deliver
// that FREE first so the backend closes the previous car's session before the
// new car's OCCUPIED/photo arrive. Returns false if the FREE still can't be
// sent (caller should hold off sending the OCCUPIED so ordering is preserved).
bool deliverPendingSessionEnd(int batteryPercent) {
  if (!pendingTelemetry.sessionEndUndelivered) {
    return true;
  }
  if (postTelemetry(STATE_FREE, batteryPercent)) {
    pendingTelemetry.sessionEndUndelivered = 0;
    persistPendingTelemetry();
    Serial.println("Delivered dropped car-left (FREE) before next arrival.");
    return true;
  }
  return false;
}

void loadCalibration() {
  baselineDistanceCm = PARKME_SENSOR_DEFAULT_BASELINE_CM;
  // Technician-set trigger distance; compiled default until calibrated once.
  occupiedThresholdCm =
      preferences.getFloat("thr_cm", PARKME_SENSOR_OCCUPIED_THRESHOLD_CM);
}

void saveCalibration(float measuredTargetCm) {
  // The measured target distance itself becomes the trigger (plus a small
  // margin), so the technician freely chooses any trigger distance by simply
  // placing the target where a car should be detected.
  occupiedThresholdCm =
      clampValue(measuredTargetCm + PARKME_SENSOR_CALIBRATION_MARGIN_CM,
                 PARKME_SENSOR_MIN_THRESHOLD_CM,
                 PARKME_SENSOR_CALIBRATION_MAX_TARGET_CM);
  preferences.putFloat("thr_cm", occupiedThresholdCm);
}

float sampleAverageDistance(uint8_t sampleCount) {
  float total = 0.0f;
  uint8_t validSamples = 0;

  for (uint8_t i = 0; i < sampleCount; ++i) {
    float distanceCm = readDistanceCm();
    if (distanceCm > 0.0f && distanceCm <= kSensorMeasurementCapCm) {
      total += distanceCm;
      ++validSamples;
    }
    delay(120);
  }

  return validSamples == 0 ? -1.0f : (total / validSamples);
}

void runCalibrationMode() {
  Serial.println(
      "Calibration mode started. Place an object at the desired trigger "
      "distance (up to 50 cm).");
  showScreen("Calibrating", "Measuring target");
  float measuredCm = sampleAverageDistance(15);

  if (measuredCm <= 0.0f) {
    Serial.println(
        "Calibration FAILED: no echo received. Keeping previous threshold.");
    showScreen("Calibrate FAIL", "No echo");
    delay(3000);
    showLocalSensorScreen();
    return;
  }

  if (measuredCm > PARKME_SENSOR_CALIBRATION_MAX_TARGET_CM) {
    Serial.print("Calibration FAILED: target measured at ");
    Serial.print(measuredCm);
    Serial.print(" cm, beyond the ");
    Serial.print(PARKME_SENSOR_CALIBRATION_MAX_TARGET_CM);
    Serial.println(" cm maximum. Keeping previous threshold.");
    showScreen("Calibrate FAIL", "Target too far");
    delay(3000);
    showLocalSensorScreen();
    return;
  }

  saveCalibration(measuredCm);
  Serial.print("Calibration PASS. Target measured at ");
  Serial.print(measuredCm);
  Serial.print(" cm | New trigger distance: ");
  Serial.print(occupiedThresholdCm);
  Serial.println(" cm (saved to flash)");
  showScreen("Calibrate PASS",
             "Trigger " + String(occupiedThresholdCm, 0) + "cm");
  delay(3000);
  showLocalSensorScreen();
}

float readBatteryVoltage() {
  if (PARKME_SENSOR_BATTERY_PIN < 0) {
    return PARKME_SENSOR_BATTERY_FULL_V;
  }

  uint32_t millivolts = analogReadMilliVolts(PARKME_SENSOR_BATTERY_PIN);
  float measuredVoltage = millivolts / 1000.0f;
  return measuredVoltage * PARKME_SENSOR_VOLTAGE_DIVIDER_RATIO;
}

int readBatteryPercent() {
  return batteryPercentFromVoltage(readBatteryVoltage(),
                                   PARKME_SENSOR_BATTERY_EMPTY_V,
                                   PARKME_SENSOR_BATTERY_FULL_V);
}

bool connectWiFi() {
  lastWifiAttemptAtMs = millis();

  showScreen("Connecting WiFi", "Please wait");
  Serial.print("Connecting to WiFi");
  WiFi.begin(PARKME_WIFI_SSID, PARKME_WIFI_PASSWORD);

  unsigned long startedAtMs = millis();
  while (WiFi.status() != WL_CONNECTED && millis() - startedAtMs < 12000) {
    delay(400);
    Serial.print(".");
  }

  Serial.println();
  if (WiFi.status() == WL_CONNECTED) {
    lastKnownWifiChannel = WiFi.channel();
    Serial.print("Connected. IP: ");
    Serial.print(WiFi.localIP());
    Serial.print(" channel: ");
    Serial.println(lastKnownWifiChannel);
    Serial.print("MAC: ");
    Serial.println(WiFi.macAddress());
    showLocalSensorScreen();
    return true;
  }

  // Park the radio back on the AP's channel so ESP-NOW broadcasts to the
  // camera stay on the channel it listens on while WiFi is down. Without
  // this, channel scans leave the two boards on different channels during
  // long outages and the camera never receives the occupancy triggers.
  WiFi.disconnect();
  uint8_t pinChannel = lastKnownWifiChannel > 0 ? lastKnownWifiChannel : 1;
  esp_wifi_set_channel(pinChannel, WIFI_SECOND_CHAN_NONE);
  Serial.print("WiFi connection failed. Radio pinned to channel ");
  Serial.println(pinChannel);
  showScreen("WiFi failed", "Retrying");
  return false;
}

// Reconnect attempt for the network task (Core 0). Deliberately touches no
// screen state — the OLED belongs to Core 1. Blocking here is fine: sensing,
// rendering, and ESP-NOW broadcasts continue on the other core.
void reconnectWiFiFromNetworkTask() {
  if (WiFi.status() == WL_CONNECTED) {
    return;
  }

  unsigned long nowMs = millis();
  if (nowMs - lastWifiAttemptAtMs < PARKME_SENSOR_WIFI_RETRY_INTERVAL_MS) {
    return;
  }
  lastWifiAttemptAtMs = nowMs;

  Serial.println("[Network] Reconnecting WiFi...");
  WiFi.begin(PARKME_WIFI_SSID, PARKME_WIFI_PASSWORD);

  unsigned long startedAtMs = millis();
  while (WiFi.status() != WL_CONNECTED && millis() - startedAtMs < 12000) {
    delay(400);
  }

  if (WiFi.status() == WL_CONNECTED) {
    lastKnownWifiChannel = WiFi.channel();
    Serial.print("[Network] WiFi reconnected. IP: ");
    Serial.print(WiFi.localIP());
    Serial.print(" channel: ");
    Serial.println(lastKnownWifiChannel);
    return;
  }

  // Park the radio back on the AP channel so ESP-NOW broadcasts to the
  // camera keep going out on the channel it listens on.
  WiFi.disconnect();
  uint8_t pinChannel = lastKnownWifiChannel > 0 ? lastKnownWifiChannel : 1;
  esp_wifi_set_channel(pinChannel, WIFI_SECOND_CHAN_NONE);
  Serial.print("[Network] WiFi still down. Radio pinned to channel ");
  Serial.println(pinChannel);
}

bool postTelemetry(SpotState state, int batteryPercent) {
  if (WiFi.status() != WL_CONNECTED) {
    return false;
  }

  HTTPClient http;
  http.setTimeout(PARKME_SENSOR_HTTP_TIMEOUT_MS);

  String url =
      buildServerUrl(PARKME_SERVER_SCHEME,
                     PARKME_SERVER_HOST,
                     PARKME_SERVER_PORT,
                     PARKME_API_UPDATE_SPOT_PATH);
  WiFiClient plainClient;
  WiFiClientSecure secureClient;
  bool usingHttps = String(PARKME_SERVER_SCHEME).equalsIgnoreCase("https");
  bool beganRequest = false;

  if (usingHttps) {
    secureClient.setInsecure();
    beganRequest = http.begin(secureClient, url);
  } else {
    beganRequest = http.begin(plainClient, url);
  }

  if (!beganRequest) {
    Serial.println("HTTP begin failed.");
    return false;
  }

  http.addHeader("Content-Type", "application/json");
  String payload = makeHeartbeatPayload(WiFi.macAddress(),
                                        state,
                                        batteryPercent);

  int statusCode = http.POST(payload);
  String response = http.getString();
  http.end();

  Serial.print("POST ");
  Serial.print(payload);
  Serial.print(" -> ");
  Serial.print(statusCode);
  Serial.print(" | ");
  Serial.println(response);

  return statusCode >= 200 && statusCode < 300;
}

bool shouldSendTelemetry(SpotState currentState, unsigned long nowMs) {
  if (!isKnownState(currentState)) {
    return false;
  }

  if (!isKnownState(lastPublishedState)) {
    return true;
  }

  if (stateChanged(lastPublishedState, currentState)) {
    return true;
  }

  return shouldSendHeartbeat(currentState, PARKME_SENSOR_ALLOW_FREE_HEARTBEATS) &&
         (nowMs - lastSuccessfulPublishAtMs >=
          PARKME_SENSOR_HEARTBEAT_INTERVAL_MS);
}

float currentFreeDistanceLimitCm() {
  return computeFreeDistanceLimit(baselineDistanceCm,
                                  PARKME_SENSOR_MAX_RELIABLE_DISTANCE_CM,
                                  PARKME_SENSOR_OCCUPIED_DELTA_CM);
}

void markTelemetrySent(SpotState state) {
  lastPublishedState = state;
  lastSuccessfulPublishAtMs = millis();
}

void flushPendingTelemetry() {
  if (!pendingTelemetry.valid || WiFi.status() != WL_CONNECTED) {
    return;
  }

  // Close the previous car's session first if a FREE was dropped from the
  // queue; hold off on the pending state until that FREE is delivered.
  if (!deliverPendingSessionEnd(pendingTelemetry.batteryPercent)) {
    return;
  }

  SpotState pendingState = static_cast<SpotState>(pendingTelemetry.status);
  if (postTelemetry(pendingState, pendingTelemetry.batteryPercent)) {
    markTelemetrySent(pendingState);
    clearPendingTelemetry();
  }
}

void publishCurrentState(float distanceCm, SpotState state) {
  int batteryPercent = readBatteryPercent();
  SpotState previousState = lastMeasuredState;
  lastMeasuredDistanceCm = distanceCm;
  lastMeasuredState = state;
  lastMeasuredBatteryPercent = batteryPercent;

  Serial.print("Distance: ");
  Serial.print(distanceCm);
  Serial.print(" cm | Threshold: ");
  Serial.print(occupiedThresholdCm);
  Serial.print(" cm | Battery: ");
  Serial.print(batteryPercent);
  Serial.print("% | State: ");
  Serial.println(state == STATE_OCCUPIED ? "OCCUPIED" : "FREE");

  if (state == STATE_FREE && previousState != STATE_FREE) {
    clearLocalCameraMessage();
  }

  if (!isServerMessageActive() && !isLocalCameraMessageActive()) {
    showLocalSensorScreen();
  }

  sendEspNowState(state, batteryPercent);

  if (!shouldSendTelemetry(state, millis())) {
    return;
  }

  if (postTelemetry(state, batteryPercent)) {
    markTelemetrySent(state);
    clearPendingTelemetry();
  } else {
    queuePendingTelemetry(state, batteryPercent);
  }
}

void handleCalibrationButton() {
  if (!calibrationButtonPressed()) {
    calibrationButtonPressedAtMs = 0;
    return;
  }

  if (calibrationButtonPressedAtMs == 0) {
    calibrationButtonPressedAtMs = millis();
    return;
  }

  if (millis() - calibrationButtonPressedAtMs >= 4000) {
    calibrationButtonPressedAtMs = 0;
    runCalibrationMode();
  }
}

void handleSseDisplayCommand(const String &jsonData) {
  String eventType = extractJsonStringField(jsonData, "type");
  if (eventType != "display_command") {
    return;
  }
  String title = extractJsonStringField(jsonData, "title");
  String message = extractJsonStringField(jsonData, "message");
  String requestId = extractJsonStringField(jsonData, "request_id");
  unsigned long holdMs = extractJsonUnsignedLongField(jsonData, "hold_ms", 4000);

  Serial.print("[SSE] Display command: ");
  Serial.print(title);
  Serial.print(" | ");
  Serial.println(message);

  if (xSemaphoreTake(sharedStateMutex, pdMS_TO_TICKS(50))) {
    copyStringToFixedBuffer(title, const_cast<char *>(sharedDisplay.title), sizeof(sharedDisplay.title));
    copyStringToFixedBuffer(message, const_cast<char *>(sharedDisplay.message), sizeof(sharedDisplay.message));
    copyStringToFixedBuffer(requestId, const_cast<char *>(sharedDisplay.requestId), sizeof(sharedDisplay.requestId));
    sharedDisplay.holdMs = holdMs;
    sharedDisplay.hasNew = true;
    xSemaphoreGive(sharedStateMutex);
  }
}

void processPendingTelemetryAndAcks() {
  flushPendingTelemetry();

  bool shouldSend = false;
  SpotState stateToSend = STATE_UNKNOWN;
  int batteryToSend = 100;
  if (xSemaphoreTake(sharedStateMutex, pdMS_TO_TICKS(50))) {
    if (sharedSensor.needsTelemetry) {
      shouldSend = true;
      stateToSend = sharedSensor.state;
      batteryToSend = sharedSensor.batteryPercent;
      sharedSensor.needsTelemetry = false;
    }
    xSemaphoreGive(sharedStateMutex);
  }

  if (shouldSend) {
    // A fresh OCCUPIED must not jump ahead of a dropped car-left FREE, or the
    // backend keeps the previous car's session open and rejects this car's
    // photo. If the FREE still can't go out, queue this state and retry later.
    bool sessionEndReady =
        stateToSend != STATE_OCCUPIED || deliverPendingSessionEnd(batteryToSend);
    if (!sessionEndReady) {
      queuePendingTelemetry(stateToSend, batteryToSend);
    } else if (postTelemetry(stateToSend, batteryToSend)) {
      if (xSemaphoreTake(sharedStateMutex, pdMS_TO_TICKS(50))) {
        sharedNetwork.lastTelemetrySentAtMs = millis();
        xSemaphoreGive(sharedStateMutex);
      }
      markTelemetrySent(stateToSend);
      clearPendingTelemetry();
    } else {
      queuePendingTelemetry(stateToSend, batteryToSend);
    }
  }

  bool shouldAck = false;
  String ackRequestId = "";
  if (xSemaphoreTake(sharedStateMutex, pdMS_TO_TICKS(50))) {
    if (sharedDisplay.needsAck) {
      shouldAck = true;
      ackRequestId = String((const char*)sharedDisplay.requestId);
      sharedDisplay.needsAck = false;
    }
    xSemaphoreGive(sharedStateMutex);
  }
  
  if (shouldAck && ackRequestId.length() > 0) {
    sendDisplayResult(ackRequestId, "DISPLAYED", "rendered");
  }
}

bool connectAndReadSseStream() {
  WiFiClient plainClient;
  WiFiClientSecure secureClient;
  bool usingHttps = String(PARKME_SERVER_SCHEME).equalsIgnoreCase("https");
  Client *client = usingHttps ? static_cast<Client *>(&secureClient) : static_cast<Client *>(&plainClient);
  if (usingHttps) {
    secureClient.setInsecure();
  }

  if (!client->connect(PARKME_SERVER_HOST, PARKME_SERVER_PORT)) {
    Serial.println("[SSE] Cannot reach backend.");
    return false;
  }

  String request = "GET /api/v1/displays/stream?display_id=";
  request += PARKME_DISPLAY_ID;
  request += " HTTP/1.1\r\n";
  request += "Host: ";
  request += PARKME_SERVER_HOST;
  request += "\r\n";
  request += "Accept: text/event-stream\r\n";
  request += "Connection: keep-alive\r\n\r\n";
  client->print(request);

  unsigned long headerWaitStart = millis();
  while (!client->available() && client->connected() && millis() - headerWaitStart < 5000) {
    delay(10);
  }
  if (!client->available()) {
    client->stop();
    Serial.println("[SSE] No response from server.");
    return false;
  }

  String statusLine = client->readStringUntil('\n');
  int statusCode = parseHttpStatusCode(statusLine);
  if (statusCode != 200) {
    Serial.print("[SSE] Server returned HTTP ");
    Serial.println(statusCode);
    client->stop();
    return false;
  }

  while (client->connected()) {
    String headerLine = client->readStringUntil('\n');
    if (headerLine == "\r" || headerLine.length() == 0) {
      break;
    }
  }

  Serial.println("[SSE] Stream connected.");
  sseStreamActive = true;
  sseReconnectDelayMs = SSE_RECONNECT_BASE_DELAY_MS;

  if (xSemaphoreTake(sharedStateMutex, pdMS_TO_TICKS(50))) {
    sharedNetwork.sseConnected = true;
    xSemaphoreGive(sharedStateMutex);
  }

  String dataBuffer = "";
  unsigned long lastTaskCheckMs = millis();
  while (client->connected()) {
    if (client->available()) {
      String line = client->readStringUntil('\n');
      line.trim();
      if (line.startsWith("data: ")) {
        dataBuffer = line.substring(6);
      } else if (line.length() == 0 && dataBuffer.length() > 0) {
        handleSseDisplayCommand(dataBuffer);
        dataBuffer = "";
      }
    } else {
      delay(10);
    }

    if (millis() - lastTaskCheckMs > 100) {
      lastTaskCheckMs = millis();
      processPendingTelemetryAndAcks();
    }
  }

  client->stop();
  sseStreamActive = false;
  Serial.println("[SSE] Stream disconnected.");

  if (xSemaphoreTake(sharedStateMutex, pdMS_TO_TICKS(50))) {
    sharedNetwork.sseConnected = false;
    xSemaphoreGive(sharedStateMutex);
  }

  return true;
}

void handleDisplayPollingFallback() {
  if (WiFi.status() != WL_CONNECTED) {
    return;
  }
  if (millis() - lastDisplayPollAtMs < PARKME_DISPLAY_COMMAND_POLL_INTERVAL_MS) {
    return;
  }
  lastDisplayPollAtMs = millis();

  String requestId;
  String title;
  String message;
  unsigned long holdMs = 4000;
  if (pollDisplayCommand(requestId, title, message, holdMs)) {
    Serial.print("[Poll Fallback] Display command: ");
    Serial.println(requestId);
    if (xSemaphoreTake(sharedStateMutex, pdMS_TO_TICKS(50))) {
      copyStringToFixedBuffer(title, const_cast<char *>(sharedDisplay.title), sizeof(sharedDisplay.title));
      copyStringToFixedBuffer(message, const_cast<char *>(sharedDisplay.message), sizeof(sharedDisplay.message));
      copyStringToFixedBuffer(requestId, const_cast<char *>(sharedDisplay.requestId), sizeof(sharedDisplay.requestId));
      sharedDisplay.holdMs = holdMs;
      sharedDisplay.hasNew = true;
      xSemaphoreGive(sharedStateMutex);
    }
    sendDisplayResult(requestId, "DISPLAYED", "rendered");
  }
}

void networkTask(void *parameter) {
  Serial.print("[Network] Task started on core ");
  Serial.println(xPortGetCoreID());

  for (;;) {
    if (WiFi.status() != WL_CONNECTED) {
      if (xSemaphoreTake(sharedStateMutex, pdMS_TO_TICKS(50))) {
        sharedNetwork.wifiConnected = false;
        sharedNetwork.sseConnected = false;
        xSemaphoreGive(sharedStateMutex);
      }
      // With SDK auto-reconnect disabled (channel pinning for ESP-NOW),
      // this task owns reconnection. Paced by the retry interval; blocks
      // only this core.
      reconnectWiFiFromNetworkTask();
      delay(1000);
      continue;
    }

    if (xSemaphoreTake(sharedStateMutex, pdMS_TO_TICKS(50))) {
      sharedNetwork.wifiConnected = true;
      xSemaphoreGive(sharedStateMutex);
    }

    processPendingTelemetryAndAcks();

    if (!sseStreamActive) {
      unsigned long now = millis();
      if (now - lastSseAttemptAtMs >= sseReconnectDelayMs) {
        lastSseAttemptAtMs = now;
        bool wasConnected = connectAndReadSseStream();
        if (!wasConnected) {
          sseReconnectDelayMs = min(sseReconnectDelayMs * 2, SSE_RECONNECT_MAX_DELAY_MS);
          Serial.print("[SSE] Next retry in ");
          Serial.print(sseReconnectDelayMs);
          Serial.println("ms");
        }
      } else {
        handleDisplayPollingFallback();
      }
    }

    delay(50);
  }
}

void checkSharedDisplayCommand() {
  if (!xSemaphoreTake(sharedStateMutex, pdMS_TO_TICKS(10))) {
    return;
  }
  if (!sharedDisplay.hasNew) {
    xSemaphoreGive(sharedStateMutex);
    return;
  }
  String title = String((const char*)sharedDisplay.title);
  String message = String((const char*)sharedDisplay.message);
  unsigned long holdMs = sharedDisplay.holdMs;
  sharedDisplay.hasNew = false;
  sharedDisplay.needsAck = true;
  xSemaphoreGive(sharedStateMutex);

  Serial.print("[Display] Server command: ");
  Serial.print(title);
  Serial.print(" | ");
  Serial.println(message);

  clearLocalCameraMessage();
  activeMessageUntilAtMs = millis() + holdMs;
  showScreen(title.length() > 0 ? title : "ParkMe", message);
}

void handleTimedMessageExpiry() {
  bool shouldRefreshScreen = false;
  if (activeMessageUntilAtMs > 0 &&
      static_cast<long>(millis() - activeMessageUntilAtMs) >= 0) {
    activeMessageUntilAtMs = 0;
    shouldRefreshScreen = true;
  }
  if (localCameraMessageUntilAtMs > 0 &&
      static_cast<long>(millis() - localCameraMessageUntilAtMs) >= 0) {
    clearLocalCameraMessage();
    shouldRefreshScreen = true;
  }
  if (shouldRefreshScreen) {
    showPreferredLocalScreen();
  }
}

void publishCurrentStateLocal(float distanceCm, SpotState state) {
  int batteryPercent = readBatteryPercent();
  SpotState previousState = lastMeasuredState;
  lastMeasuredDistanceCm = distanceCm;
  lastMeasuredState = state;
  lastMeasuredBatteryPercent = batteryPercent;

  Serial.print("Distance: ");
  Serial.print(distanceCm);
  Serial.print(" cm | Threshold: ");
  Serial.print(occupiedThresholdCm);
  Serial.print(" cm | Battery: ");
  Serial.print(batteryPercent);
  Serial.print("% | State: ");
  Serial.println(state == STATE_OCCUPIED ? "OCCUPIED" : "FREE");

  if (state == STATE_FREE && previousState != STATE_FREE) {
    clearLocalCameraMessage();
  }
  if (!isServerMessageActive() && !isLocalCameraMessageActive()) {
    showLocalSensorScreen();
  }
  sendEspNowState(state, batteryPercent);

  if (shouldSendTelemetry(state, millis())) {
    if (xSemaphoreTake(sharedStateMutex, pdMS_TO_TICKS(10))) {
      sharedSensor.state = state;
      sharedSensor.batteryPercent = batteryPercent;
      sharedSensor.needsTelemetry = true;
      xSemaphoreGive(sharedStateMutex);
    }
  }
}

void setup() {
  Serial.begin(115200);
  delay(200);

  graphicsReady = beginGraphicsDisplay();
  showScreen("ParkMe", "Booting");

  pinMode(PARKME_SENSOR_TRIG_PIN, OUTPUT);
  pinMode(PARKME_SENSOR_ECHO_PIN, INPUT);

  if (PARKME_SENSOR_CALIBRATE_PIN >= 0) {
    pinMode(PARKME_SENSOR_CALIBRATE_PIN, INPUT_PULLUP);
  }

  if (PARKME_SENSOR_BATTERY_PIN >= 0) {
    analogReadResolution(12);
    analogSetPinAttenuation(PARKME_SENSOR_BATTERY_PIN, ADC_11db);
  }

  preferences.begin("parkme-node", false);
  loadCalibration();
  loadPendingTelemetry();

  Serial.println();
  Serial.println("ParkMe Sensor Node Started");
  Serial.print("MAC: ");
  Serial.println(WiFi.macAddress());
  Serial.print("Spot ID: ");
  Serial.println(PARKME_GATE_SPOT_ID);
  Serial.print("Backend: ");
  Serial.print(PARKME_SERVER_SCHEME);
  Serial.print("://");
  Serial.print(PARKME_SERVER_HOST);
  Serial.print(":");
  Serial.println(PARKME_SERVER_PORT);
  Serial.print("Loaded baseline: ");
  Serial.print(baselineDistanceCm);
  Serial.print(" cm | Threshold: ");
  Serial.print(occupiedThresholdCm);
  Serial.println(" cm");
  Serial.print("Display ID: ");
  Serial.println(PARKME_DISPLAY_ID);

  if (calibrationButtonPressed()) {
    runCalibrationMode();
  }

  WiFi.mode(WIFI_STA);
  // Manual reconnect only (maintainWiFi): the SDK's background auto-reconnect
  // keeps scanning channels during outages, which moves the radio off the
  // pinned channel and silently breaks ESP-NOW delivery to the camera.
  WiFi.setAutoReconnect(false);
  espNowReady = initEspNow();
  connectWiFi();

  sharedStateMutex = xSemaphoreCreateMutex();
  xTaskCreatePinnedToCore(
      networkTask,
      "NetworkTask",
      NETWORK_TASK_STACK_SIZE,
      nullptr,
      1,
      &networkTaskHandle,
      0
  );
}

void loop() {
  handleCalibrationButton();

  uint8_t pendingAckStatus = 0;
  char pendingAckDetail[24] = {0};
  if (takePendingEspNowAck(pendingAckStatus, pendingAckDetail)) {
    handleCameraAckDisplay(pendingAckStatus, pendingAckDetail);
  }

  checkSharedDisplayCommand();
  handleTimedMessageExpiry();

  if (millis() - lastSampleAtMs < PARKME_SENSOR_SAMPLE_INTERVAL_MS) {
    return;
  }
  lastSampleAtMs = millis();

  float distanceCm = sampleAverageDistance(3);
  float freeDistanceLimitCm = currentFreeDistanceLimitCm();
  SpotState state = classifyDistanceCm(distanceCm, occupiedThresholdCm, freeDistanceLimitCm);

  if (!isKnownState(state)) {
    Serial.print("Sensor reading invalid. Distance: ");
    Serial.print(distanceCm);
    Serial.print(" cm | Free limit: ");
    Serial.print(freeDistanceLimitCm);
    Serial.print(" cm | Baseline: ");
    Serial.println(baselineDistanceCm);
    return;
  }

  publishCurrentStateLocal(distanceCm, state);
}
