AmerWegzyy/IOT_ParkMe/(commit log)

2026-05-26 chore: track updated gitignore constraints
2026-06-09 added arduino code
2026-06-09 chaning camera behavior to automatic triggering and max 3 times taking a picture for distance <50cm ,and hearbeating every 6 minutes
2026-06-16 feat: migrate to Google Cloud Vision API and Firebase Hosting
    - feat(backend): replace Tesseract/OpenCV with Google Cloud Vision API for license plate OCR
    - build(backend): remove heavy Tesseract dependencies from Dockerfile to reduce image size
    - build(backend): replace and with in requirements.txt
    - feat(frontend): add and configuration files to deploy the Frontend via Firebase Hosting
    - refactor(frontend): update to dynamically switch API_BASE between localhost and Cloud Run production URLs
    This completes the migration preparations to Google Cloud Platform and Firebase infrastructure.
2026-06-16 feat: migrate authentication to Firebase Auth and clean up legacy SQL database files ┃ ┃ - Migrated user authentication from a custom FastAPI JWT implementation to Firebase Auth. ┃ - Removed FastAPI 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
2026-06-16 fixing resolve button behavior
2026-06-17 Refactor: Migrate from hardcoded spot IDs to dynamic MAC address mapping
    This commit standardizes the IoT hardware deployment by making the ESP32-CAM
    nodes fully generic, relying on dynamic database mapping rather than
    hardcoded C++ firmware identifiers.
    Changes:
    - Hardware (ESP32-CAM): Removed 'PARKME_GATE_SPOT_ID'. The camera now dynamically attaches 'WiFi.macAddress()' to the 'multipart/form-
    data' payload.
    - Backend API (main.py): Refactored the 'park', 'heartbeat', and 'bulk' endpoints to intercept hardware payloads, query the
    'parking_spots' collection using 'camera_mac' or 'sensor_mac', and dynamically map them to the underlying logical 'spot_id'.
    - Da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
2026-06-17 Fix: Address multiple critical bugs across Backend, Firmware, and Documentation
    This commit resolves 10 specific bugs identified during the architecture triage session. It stabilizes memory usage, secures the
    frontend login flow, cleans up hardware payloads, and synchronizes all documentation with the final system state.
    Backend Changes:
    - Security: Completely removed the optional HMAC signature verification middleware (and related imports) to streamline device requests.
    - Memory Leak: Replaced the unbounded LPR_DEDUP_CACHE dictionary with cachetools.TTLCache (120-second TTL) to prevent long-term memory
    exhaustion.
    - Timezones: Updated resolve_spot to use get_il_time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
    [ParkMeCommon.h, ParkMeSensorNode.ino, SECRETS.example.h]
2026-06-17 Docs: Compact and consolidate project documentation
    - Consolidated all active system documentation into 5 source-of-truth files in Documentation/
    - Updated all active manuals to perfectly reflect the final system state (no HMAC, explicit sensor/camera MAC schemas, Ghost Logs, TTLCache memory leak fixes).
    - Archived all duplicate, historical, and chat-log .md files to docs/archive/ to aggressively reduce repository clutter.
    - Explicitly untracked ESP32/SECRETS.h to prevent leaking Wi-Fi credentials.
2026-06-18 contiuing the bug fixes after agent interrupted yesterday due to limit
2026-06-18 refactor(hardware): lower camera node detection threshold and fix backend bugs
    Hardware:
    - Decreased the ESP32-CAM gate detection threshold in `isCarAtGate()`
    from < 50cm to <= 20cm to improve detection accuracy.
    - Gate latch-reset logic (`carPresent`) inherently inherits the > 20cm
    clearing threshold.
    Backend (Bug Fixes):
    - fix: Updated manual deduplication check for the LPR endpoint to fully
    rely on the 120s `TTLCache` eviction window, removing the stale 5-second
    manual override (BUG-004).
    - chore: Removed deprecated `spot ids` references from the ESP32 README.
    Documentation:
    - Updated all active and archived architecture/hardware markdown files
    to reflect the new 20cm ultrason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
    [ParkMeCameraNode.ino]
2026-06-20 Switch camera to backend-triggered workflow
2026-06-23 Simplify ESP-NOW parking review flow
2026-06-23 Refactor: migrate captures to Base64, clean up legacy docs, and fix UI realtime logs
    This commit introduces a massive cleanup of deprecated architecture and implements the new realtime violation evidence feature.
    Backend & Architecture:
    - Completely removed local image storage logic and legacy SQLite (schema.sql).
    - Camera captures are now Base64 encoded and stored directly in Firestore (spot_captures for temp review, parking_logs for permanent violations).
    - Added new GET endpoints to serve decoded image bytes to the frontend.
    - Synced backend grace periods and display holds with the documented system architecture.
    - Removed points field from users and cleaned up seed_firestore.py.
    Fronte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
    [ParkMeConfig.h, SECRETS.example.h]
2026-06-23 Fix: prevent camera capture leak and disable review buttons on missing images
    - Backend: Added logic to proactively delete the temporary `spot_captures` document when a car leaves a spot (heartbeat=false). This prevents the edge case where an old violation picture could leak onto a newly parked car if the camera failed to capture a new picture.
    - Frontend: Disabled the manual Accept/Reject buttons if the camera image has not arrived or fails to load, preventing admins from blindly rejecting logs without photographic evidence.
2026-06-23 Docs: archive edge-case and architecture Q&A
    - Added `system_q_and_a.md` to the Documentation folder to permanently archive the system decisions regarding LCD timing logic, violation picture storage (Base64), bouncy driver data retention, and camera hardware failure logic.
2026-06-24 adding hardcoded camera mac to the secrets.example.h
2026-06-24 feat: implement zero-latency SSE displays and FreeRTOS dual-core split
    This major architectural upgrade eliminates display lag by moving away from Firestore-backed HTTP polling and introducing direct Server-Sent Events (SSE) with hardware-level multithreading.
    Backend Changes (main.py):
    - Added dedicated /api/v1/displays/stream SSE endpoint for zero-latency hardware pushes.
    - Replaced Firestore 'display_commands' collection with an ultra-fast in-memory dictionary.
    - Refactored queue_display_command() to broadcast directly over the SSE stream.
    - Updated /api/v1/displays/poll to serve as a lightweight fallback reading from memory.
    Firmware Changes (ParkMeSensorNode.ino):
    - Upgraded to a Free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
    [ParkMeSensorNode.ino]
2026-06-25 adding upload guide in esp32/hardware-upload-guide.md
2026-06-25 Fix: use PARKME_GATE_SPOT_ID instead of undeclared PARKME_SENSOR_SPOT_ID
    [ParkMeSensorNode.ino]
2026-06-25 Fix: Send telemetry heartbeats and display ACKs even while SSE stream is connected
    [ParkMeSensorNode.ino]
2026-06-25 fixing camera buffer issue
    [ParkMeCameraNode.ino]
2026-06-26 Fix old photo bug and add upload retry loop
    - Added double dummy grab to fully clear stale frames from PSRAM FIFO
    - Replaced PSRAM caching with immediate HTTP retry loop (max 3 retries)
    [ParkMeCameraNode.ino]
2026-07-10 Finalize backend, docs, and ESP32 updates
2026-07-11 Fix OLED digit glyphs rendering upside down; add user-story audit docs
    Ten digit glyphs (0-9) in the sensor node's hand-rolled OLED font were
    authored with bit 0 = bottom row, opposite of the letter glyphs and the
    renderer's convention (bit 0 = top row). Digits like 2, 4, 5, 7 rendered
    visibly wrong, and 6/9 swapped into each other. Rebuilt all ten glyphs
    to match the correct convention.
    Also adds Documentation/USER_STORIES.md (audit requirements source),
    Documentation/USER_STORY_IMPLEMENTATION_AUDIT.md (fresh code-first audit
    against it), and the audit prompt used to generate it.
    [ParkMeSensorNode.ino]
2026-07-11 Rework calibration to set trigger distance directly by demonstration
    Replace the baseline-minus-delta calibration model with direct
    target-distance calibration: place an object at the exact distance a
    car should be detected (3-50 cm) and hold the button 4s. The measured
    distance plus a small margin becomes the node's occupied threshold,
    stored in flash. This removes the old baseline-subtraction math, which
    produced an unusably small ~8cm trigger on short-range setups (empty
    baseline under ~38cm made baseline-30 hit the floor).
    Also adds Documentation/TESTING_GUIDE.md (unit/hardware/E2E/failure-
    recovery test scenarios with corrected timings) and refreshes the LPR
    pipeline log from a run aga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
    [ParkMeSensorNode.ino, SECRETS.example.h]
2026-07-11 Add system deep-dive doc, multi-spot simulator, testing guide; persist camera photo across WiFi outages
    Camera firmware: the photo taken at the moment a car arrives is now copied
    into PSRAM (heap fallback) before the driver buffer is released, so a WiFi
    outage no longer discards it. The SAME frame is re-sent once connectivity
    returns (via the sensor's 2s OCCUPIED re-broadcast); it is freed when the
    backend answers or when the spot goes free, so a stale photo is never sent
    for a car that already left.
    Documentation overhaul:
    - SYSTEM_EXPLAINED.md: full technical deep dive (ESP-NOW rationale vs cables/
    single board, dual-core design, calibration, WiFi-loss matrix, memory and
    buffers, serv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
    [ParkMeCameraNode.ino]
2026-07-17 Raise camera /park response timeout to 25s
    The /park reply includes server-side Vision OCR (up to two API calls) plus
    Firestore work; over hotspot to Cloud Run this regularly exceeds the old 7s
    window, so uploads succeeded but the camera reported "Backend response
    timeout" on every attempt. Only the camera gate timeout changes; sensor
    heartbeat timeout stays at 5s.
2026-07-17 Fix photo upload truncation over HTTPS: send JPEG body in checked chunks
    The camera sent the whole JPEG with a single client->write() and ignored the
    return value. Over HTTPS, WiFiClientSecure::write hands the buffer to mbedTLS,
    which transmits at most one TLS record (~16 KB) and returns the bytes actually
    written — so the backend received a request promising the full Content-Length
    but got only the first ~16 KB of body, waited for the rest, and never replied.
    Symptoms: "Backend response timeout" on every attempt and no photo/log ever
    created server-side, while small-bodied requests (heartbeats, JSON) worked.
    Now the body is written in 4 KB chunks with the return value checked; a short
    wr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
    [ParkMeCameraNode.ino]
2026-07-17 Fix missed-FREE capture latch, IL-band OCR misreads; speed up camera cycle
    Camera firmware:
    - A FREE that arrived while loop() was busy (upload/verdict) could be
    overwritten in the single-slot ESP-NOW mailbox by the next OCCUPIED, so a
    quick free->occupied swap kept the per-cycle capture latch set and the new
    car was never photographed. The sensor bumps its sequence on every state
    transition, so an OCCUPIED with a different sequence than the latched cycle
    now resets the cycle (clearing the latch and the previous car's photo) and
    captures fresh.
    - Removed two hardcoded 2.5s post-verdict delays: this board has no display
    (status goes to serial only) and the blocking wait both slo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
    [ParkMeCameraNode.ino]
2026-07-17 Wire partner's parallelism results into demo script; refresh test counts
    Demo script section 4 now cites tests/parallel_test_results.log directly
    with the headline numbers (15/15 correct plates, 0 cross-talk, 2.9x
    concurrency speedup) and links tests/TEST_SUMMARY.md. TEST_SUMMARY counts
    updated for the five new IL-band extraction tests (12->17 unit tests,
    31->36 deterministic checks).
2026-07-18 Add wiring diagram (SVG source + rendered PNG), link from ESP32 README
    Sensor node: HC-SR04 (TRIG=GPIO5, ECHO=GPIO18, VIN/GND), OLED SSD1306
    (SCL=GPIO22, SDA=GPIO21, 3V3/GND, addr 0x3C), calibration button
    GPIO13->GND with internal pull-up. Camera node: power only, IO0 flashing
    note. Also shows the ESP-NOW link and both HTTPS paths to Cloud Run.
    Pins match ESP32/SECRETS.h. gitignore gains an exception so documentation
    images are committable despite the global *.png ignore.
2026-07-18 Add wiring diagram, versions doc, and printable edge-case list for submission
    Course-requirement docs:
    - HARDWARE_WIRING.md: breadboard-style SVG wiring diagram + mermaid system
    overview + pin tables for both boards (pins from SECRETS.h; USB-powered,
    battery gauge documented as not connected)
    - VERSIONS.md: exact stack versions (ESP32 core, Python packages via pip
    freeze, Firebase JS SDK, cloud services)
    - EDGE_CASES.md: printable list (x3 for the demo) of the 17 handled edge
    cases with how-to-demo notes
    - README.md index updated to link the new docs
2026-07-20 Keep ESP-NOW alive during long WiFi outages by pinning the radio channel
    ESP-NOW frames are only delivered when both boards' radios sit on the same
    2.4 GHz channel. While associated to the AP that is guaranteed, but during
    an outage every reconnect attempt runs a full channel scan and the SDK's
    background auto-reconnect keeps scanning too, so after ~1 minute the sensor
    and camera end up parked on different channels and occupancy triggers stop
    arriving (camera "stops taking pictures" until WiFi returns and both boards
    re-associate). Short outages survived only because the radios had not
    drifted yet.
    Both nodes now remember the AP channel from the last successful connect,
    disable SDK auto-rec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
    [ParkMeCameraNode.ino, ParkMeSensorNode.ino, SECRETS.example.h]
2026-07-20 Sensor: own WiFi reconnection in the network task (Core 0)
    The sensor sketch defined maintainWiFi() but never called it; reconnection
    worked only via the SDK auto-reconnect that the channel-pinning change just
    disabled. The network task's disconnected branch now runs the reconnect
    attempt itself: paced by PARKME_SENSOR_WIFI_RETRY_INTERVAL_MS, no screen
    access (the OLED belongs to Core 1), pins the radio back to the AP channel
    after each failure, and the task no longer blocks before its main loop when
    booting with WiFi down. Sensing, rendering, and ESP-NOW broadcasts on
    Core 1 are never blocked by reconnect attempts.
    [ParkMeSensorNode.ino]
2026-07-20 Fix lost car-left during outage causing next car's photo to be dropped
    Scenario: car1 parks (photo uploaded), WiFi drops, car1 leaves, car2 arrives
    and is photographed, WiFi returns -> car2's data never appeared and its photo
    was silently discarded.
    Root cause: the sensor's single-slot pending-telemetry queue collapsed the
    OCCUPIED->FREE->OCCUPIED sequence during the outage: car1's FREE was
    overwritten by car2's OCCUPIED, so the backend never learned car1 left. Its
    previous_is_occupied stayed True, so the reconnect OCCUPIED was not treated as
    a new arrival and car1's recognized-plate log stayed open. car2's photo then
    hit receive_park_event's "already_processed" branch (active plate != the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
    [ParkMeSensorNode.ino]
2026-07-20 Add Firestore seed script for presentation demo plates
    Maps the plate photos in presentation_pics/ (named <plate>_<name>_<role>.jpg)
    to matching users/vehicles in Firestore so each photo produces the intended
    WELCOME/DENIED verdict live on stage. Idempotent, touches only these five
    users/vehicles; never modifies parking_spots, logs, or the four dashboard
    login accounts.
2026-07-20 Add 4 recently-hardened edge cases found on real hardware this week
    Appends a new printable section (#18-21) rather than renumbering the
    existing list: rapid same-spot re-occupation missing a photo (ESP-NOW
    mailbox + sequence-number cycle reset), ESP-NOW going silent on WiFi
    outages longer than ~1 minute (channel drift, fixed by pinning the radio
    to the last known AP channel), a car's departure getting lost during an
    outage and silently dropping the next car's photo (sensor session-end
    flag + backend guard), and the Israeli plate's "IL" band being misread
    as a phantom leading digit.
2026-07-21 Align repo with final-submission git guidelines
    - README: add Team section (names TODO), Hardware-used list WITH QUANTITIES,
    embedded wiring diagram, Software-versions pointer, Poster section (TODO),
    parameters/secrets file references, and a calibration note — the required
    root-README items from the submission guidelines.
    - ESP32/parameters.h: replace the leftover template from another project
    (it defined a keypad, I2S mic, and DAC that ParkMe doesn't use) with a real
    reference describing every hard-coded ParkMe parameter (pins, thresholds,
    timings) and pointing to SECRETS.example.h as the editable source.
    - VERSIONS.md: correct the backend versions to what was actually built i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
    [parameters.h]
